Qinyuan72/FYP/Writings_and_Reports/LM118_AY24_25_Project_Interim_Prentation.pdf

10/28/2024

1

# General Purpose Data Acquisition System Using STM32

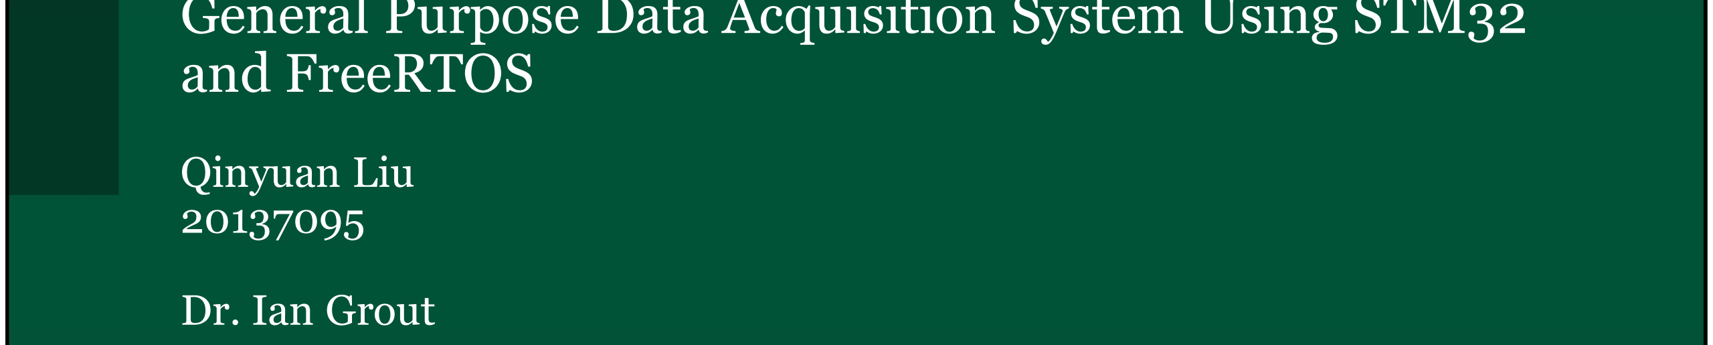
[picture p41: figure]
and FreeRTOS; Qinyuan Liu 20137095; Dr. Ian Grout

### LM118: BEng in Electronic and Computer Engineering Autumn semester 2024 Interim Presentation

# Presentation Overview

- Project introduction and objectives
- Hardware System design.
- Software System design
- Gantt chart
- Conclusions and next steps

1

2

# Project Overview – Hardware

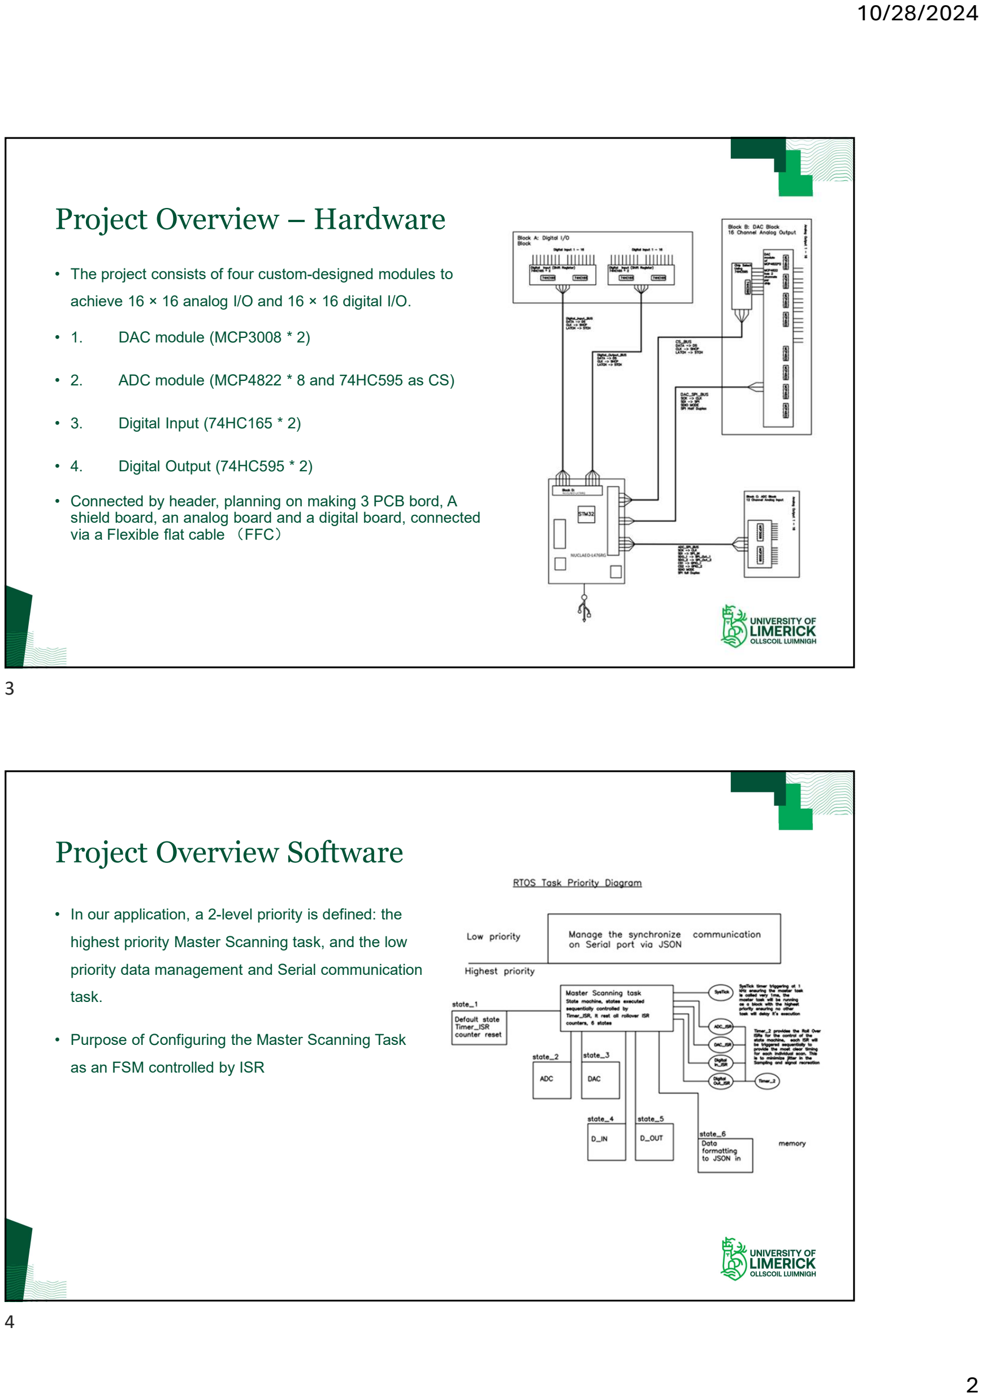
[picture p42: page 2]

2

- The project consists of four custom-designed modules to achieve 16 × 16 analog I/O and 16 × 16 digital I/O.
- 1. | DAC module (MCP3008 * 2)
- 2. | ADC module (MCP4822 * 8 and 74HC595 as CS)
- 3. | Digital Input (74HC165 * 2)
- 4. | Digital Output (74HC595 * 2)
- Connected by header, planning on making 3 PCB bord, A shield board, an analog board and a digital board, connected via a Flexible flat cable （FFC）

# Project Overview Software

- In our application, a 2-level priority is defined: the highest priority Master Scanning task, and the low priority data management and Serial communication task.
- Purpose of Configuring the Master Scanning Task as an FSM controlled by ISR

3

4

3

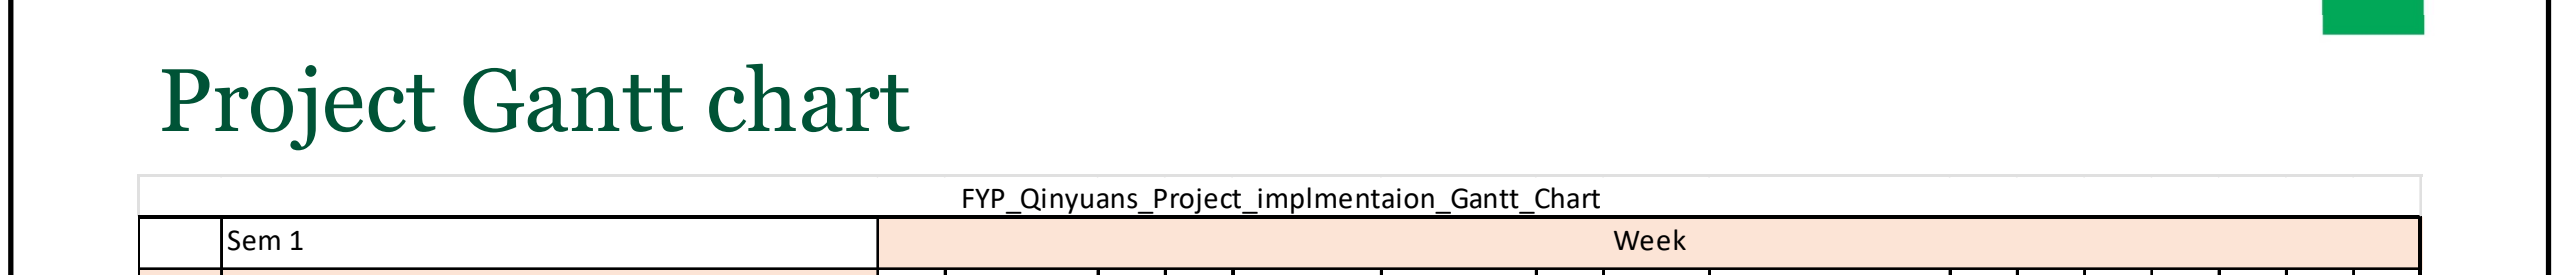
[picture p43: figure]
Project Gantt chart Sem 1

Task no. | Ground work (Background research and learning ) Task | 0 0 | 0 1 | 0 2 | 0 3 | 0 4 | 5 | 6 | 7 | 8 | 9 | 10 | 11 | 12 | 13 | 14 - 1 | END
2 | Interim Report | - | - | - | - | 0 | 0 | 0 | Dead Line Behind | Behind schedule!!!- | | - | - | - | Exam | Exam | END
3 | Schematic Design | - | - | - | - | 0 | 0 | 0 | 0 | DONE | - | - | - | - | Exam | Exam | END
4 | Autumn Semester Presentation | - | - | - | - | 0 | 0 | 0 | 0 | Due to injry, I can's persent prot ot ype (delayed), but it's well | - | - | - | - | Exam | Exam | END
5 | Code Development | - | - | - | - | - | - | - | - | 0 | 0 | 0 | 0 | 0 | Exam | Exam | END
6 | PCB Layout Task | ---1 -2 -3 -4 -5 -END ----0 0 Exam Exam END Winter Break Task no.
1 | First PCB Schematic and Layout | - | Christmas | 0 | 0 Order PCB | | | END
2 | PCB Testing | - | | - | - | - | 0 END
| Sem 2
Task no. | Final Report Due & Presentation Task | -- | 1 0 | 2 0 | 3 0 | 4 0 | 5 0 | 6 0 Final Report Due & | 7 | 8 | END 9 | - | - | - | - | - | - 1
2 | PCB with STM32 on borad | - | 0 Ord | | - | - | - | - | - | | END
3 | PCB Testing | - | - | - | 0 | 0 | Syst em Verif icat ion | - | - | | END

## Week Week Week

FYP_Qinyuans_Project_implmentaion_Gantt_Chart

# Conclusions

- Project summary:
- Prototype schematics done, the nest step will of implementing the prototype will exciting yet challenging, I am expecting imperfection and improvement in the current schematics, as well as challenges in implementing the relatively complexed RTOS code architecture, after prototype, we will be focused on dishing the custom PCB.
- Work completed to-date:
- Significant progress has been made in understanding and developing the foundations of the project, a schematic has been made while the breadboard testing prototype is under development.
- Next steps:
- Hard ware: Finish the porotype on a bread board.
- Soft ware: Finish the prototype some ware that will be the foundation in next step.

5

6

4

Thank you.

# Any questions?

7
