Qinyuan72/FYP/STM32CubeIDEworkspace_1.13.0/MCP3008/MCP3008.pdf

14/11/2024

MCP3008 Project
Configuration Report

## 1. Description

### 1.1. Project

Project Name | MCP3008
Board Name | NUCLEO-L476RG
Generated with: | STM32CubeMX 6.11.0
Date | 11/14/2024

### 1.2. MCU

MCU Series | STM32L4
MCU Line | STM32L4x6
MCU name | STM32L476RGTx
MCU Package | LQFP64
MCU Pin number | 64

### 1.3. Core(s) information

Core(s) | Arm Cortex-M4

## 2. Pinout Configuration

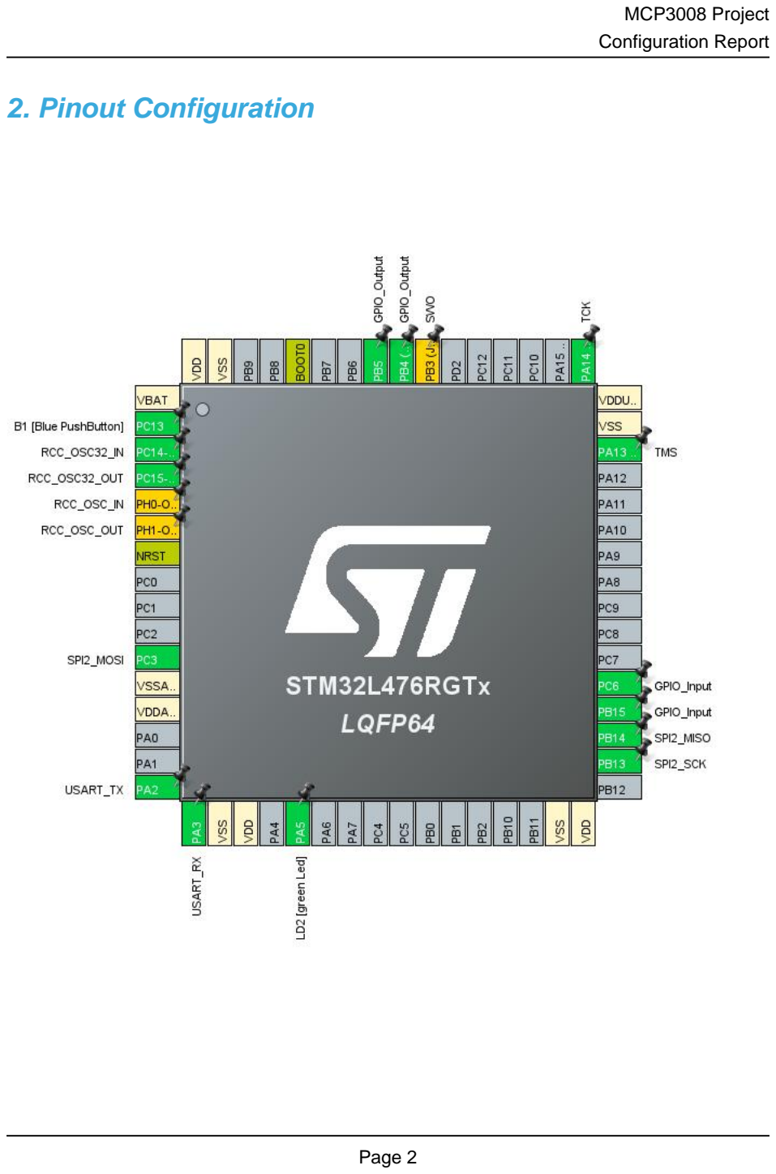
[picture p50: page 3]

## 3. Pins Configuration

Pin Number LQFP64 | Pin Name (function after reset) | Pin Type | Alternate Function(s) | Label
1 | VBAT | Power
2 | PC13 | I/O | GPIO_EXTI13 | B1 [Blue PushButton]
3 | PC14-OSC32_IN (PC14) | I/O | RCC_OSC32_IN
4 | PC15-OSC32_OUT (PC15) | I/O | RCC_OSC32_OUT
5 | PH0-OSC_IN (PH0) * | I/O | RCC_OSC_IN
6 | PH1-OSC_OUT (PH1) * | I/O | RCC_OSC_OUT
7 | NRST | Reset
11 | PC3 | I/O | SPI2_MOSI
12 | VSSA/VREF- | Power
13 | VDDA/VREF+ | Power
16 | PA2 | I/O | USART2_TX | USART_TX
17 | PA3 | I/O | USART2_RX | USART_RX
18 | VSS | Power
19 | VDD | Power
21 | PA5 ** | I/O | GPIO_Output | LD2 [green Led]
31 | VSS | Power
32 | VDD | Power
34 | PB13 | I/O | SPI2_SCK
35 | PB14 | I/O | SPI2_MISO
36 | PB15 ** | I/O | GPIO_Input
37 | PC6 ** | I/O | GPIO_Input
46 | PA13 (JTMS-SWDIO) | I/O | SYS_JTMS-SWDIO | TMS
47 | VSS | Power
48 | VDDUSB | Power
49 | PA14 (JTCK-SWCLK) | I/O | SYS_JTCK-SWCLK | TCK
55 | PB3 (JTDO-TRACESWO) * | I/O | SYS_JTDO-SWO | SWO
56 | PB4 (NJTRST) ** | I/O | GPIO_Output
57 | PB5 ** | I/O | GPIO_Output
60 | BOOT0 | Boot
63 | VSS | Power
64 | VDD | Power

** The pin is affected with an I/O function
* The pin is affected with a peripheral function but no peripheral mode is activated

## 4. Clock Tree Configuration

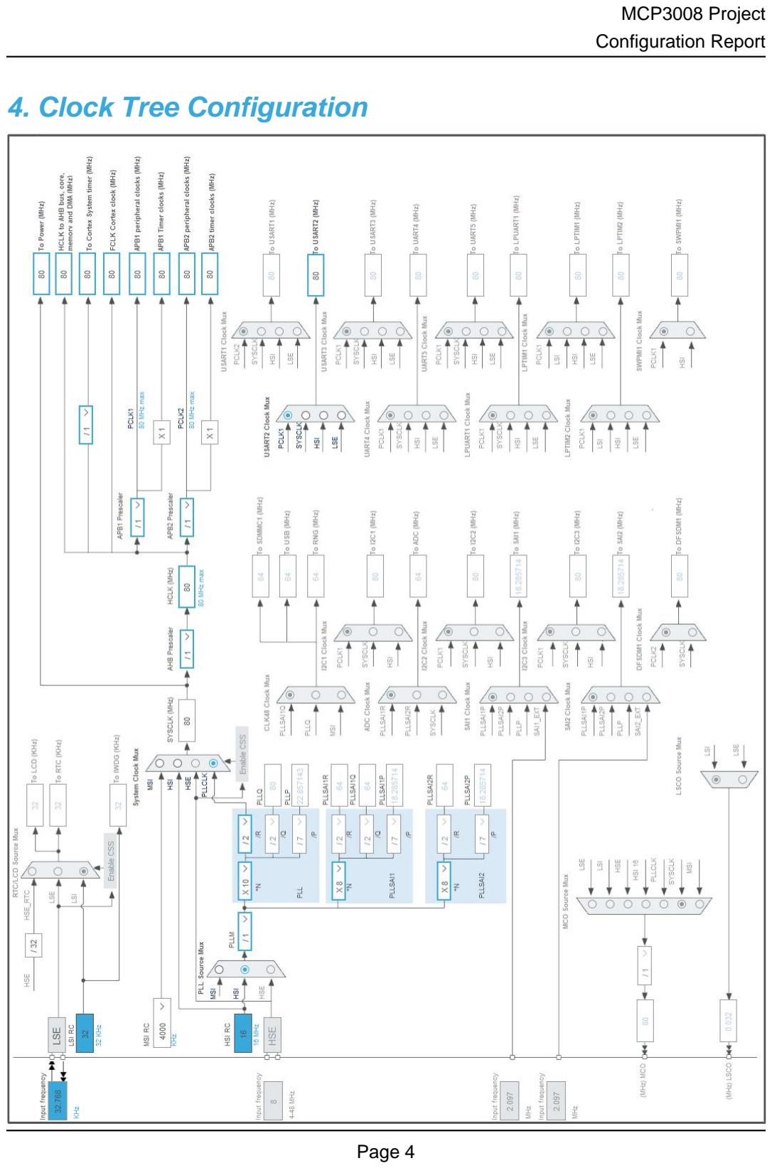
[picture p51: page 5]

## 5. Software Project

### 5.1. Project Settings

Name | Value
Project Name | MCP3008
Project Folder | D:\Develop\FYP\STM32CubeIDEworkspace_1.13.0\MCP3008
Toolchain / IDE | STM32CubeIDE
Firmware Package Name and Version | STM32Cube FW_L4 V1.18.1
Application Structure | Advanced
Generate Under Root | Yes
Do not generate the main() | No
Minimum Heap Size | 0x200
Minimum Stack Size | 0x400

### 5.2. Code Generation Settings

Name | Value
STM32Cube MCU packages and embedded software | Copy only the necessary library files
Generate peripheral initialization as a pair of '.c/.h' files | No
Backup previously generated files when re-generating | No
Keep User Code when re-generating | Yes
Delete previously generated files when not re-generated | Yes
Set all free pins as analog (to optimize the power consumption) | No
Enable Full Assert | No

### 5.3. Advanced Settings - Generated Function Calls

Rank | Function Name | Peripheral Instance Name
1 | SystemClock_Config | RCC
2 | MX_GPIO_Init | GPIO
3 | MX_USART2_UART_Init | USART2
4 | MX_SPI2_Init | SPI2

## 1. Power Consumption Calculator report

### 1.1. Microcontroller Selection

Series | STM32L4
Line | STM32L4x6
MCU | STM32L476RGTx
Datasheet | DS10198_Rev4

### 1.2. Parameter Selection

Temperature | 25
Vdd | 3.0

### 1.3. Battery Selection

Battery | Li-SOCL2(A3400)
Capacity | 3400.0 mAh
Self Discharge | 0.08 %/month
Nominal Voltage | 3.6 V
Max Cont Current | 100.0 mA
Max Pulse Current | 200.0 mA
Cells in series | 1
Cells in parallel | 1

### 1.4. Sequence

Step | Step1 | Step2
Mode | RUN | STOP2
Vdd | 3.0 | 3.0
Voltage Source | Battery | Battery
Range | Range1-High | NoRange
Fetch Type | SRAM2 | n/a
CPU Frequency | 80 MHz | 0 Hz
Clock Configuration | HSE PLL | ALL CLOCKS OFF
Clock Source Frequency | 4 MHz | 0 Hz
Peripherals
Additional Cons. | 0 mA | 0 mA
Average Current | 10.7 mA | 1.18 µA
Duration | 0.1 ms | 0.9 ms
DMIPS | 100.0 | 0.0
Ta Max | 103.56 | 105
Category | In DS Table | In DS Table

### 1.5. Results

Sequence Time | 1 ms | Average Current | 1.07 mA
Battery Life | 4 months, 10 days, 3 hours | Average DMIPS | 100.0 DMIPS

### 1.6. Chart

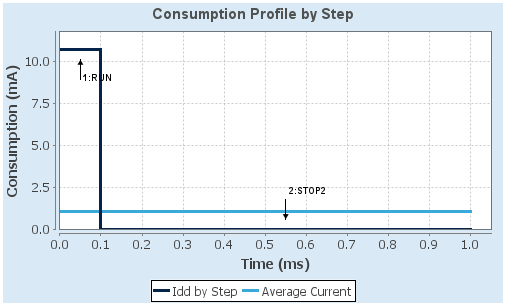
[picture p52: figure]

## 2. Peripherals and Middlewares Configuration

### 2.1. RCC

Low Speed Clock (LSE) : Crystal/Ceramic Resonator
2.1.1. Parameter Settings:

System Parameters:

VDD voltage (V) | 3.3
Instruction Cache | Enabled
Prefetch Buffer | Enabled *
Data Cache | Enabled
Flash Latency(WS) | 4 WS (5 CPU cycle)
RCC Parameters:
HSI Calibration Value | 16
MSI Calibration Value | 0
MSI Auto Calibration | Disabled
HSE Startup Timout Value (ms) | 100
LSE Startup Timout Value (ms) | 5000
Power Parameters:
Power Regulator Voltage Scale | Power Regulator Voltage Scale 1

### 2.2. SPI2

Mode: Full-Duplex Master
2.2.1. Parameter Settings:

Basic Parameters:

Frame Format | Motorola
Data Size | 4 Bits
First Bit | MSB First
Clock Parameters:
Prescaler (for Baud Rate) | 2
Baud Rate | 40.0 MBits/s *
Clock Polarity (CPOL) | Low
Clock Phase (CPHA) | 1 Edge
Advanced Parameters:
CRC Calculation | Disabled
NSSP Mode | Enabled
NSS Signal Type | Software

### 2.3. SYS

Debug: Serial Wire
Timebase Source: SysTick

### 2.4. USART2

Mode: Asynchronous
2.4.1. Parameter Settings:

Basic Parameters:

Baud Rate | 115200
Word Length | 8 Bits (including Parity)
Parity | None
Stop Bits | 1
Advanced Parameters:
Data Direction | Receive and Transmit
Over Sampling | 16 Samples
Single Sample | Disable
Advanced Features:
Auto Baudrate | Disable
TX Pin Active Level Inversion | Disable
RX Pin Active Level Inversion | Disable
Data Inversion | Disable
TX and RX Pins Swapping | Disable
Overrun | Enable
DMA on RX Error | Enable
MSB First | Disable

* User modified value

## 3. System Configuration

### 3.1. GPIO configuration

IP | Pin | Signal | GPIO mode | GPIO pull/up pull down | Max Speed | User Label
RCC | PC14-OSC32_IN (PC14) | RCC_OSC32_IN | n/a | n/a | n/a
| PC15-OSC32_OU T (PC15) | RCC_OSC32_O UT | n/a | n/a | n/a
SPI2 | PC3 | SPI2_MOSI | Alternate Function Push Pull | No pull-up and no pull-down | Very High *
| PB13 | SPI2_SCK | Alternate Function Push Pull | No pull-up and no pull-down | Very High *
| PB14 | SPI2_MISO | Alternate Function Push Pull | No pull-up and no pull-down | Very High *
SYS | PA13 (JTMS-SWDIO) | SYS_JTMS-SWDIO | n/a | n/a | n/a | TMS
| PA14 (JTCK-SWCLK) | SYS_JTCK-SWCLK | n/a | n/a | n/a | TCK
USART2 | PA2 | USART2_TX | Alternate Function Push Pull | No pull-up and no pull-down | Very High * | USART_TX
| PA3 | USART2_RX | Alternate Function Push Pull | No pull-up and no pull-down | Very High * | USART_RX
Single Mapped Signals | PH0-OSC_IN (PH0) | RCC_OSC_IN | n/a | n/a | n/a
| PH1-OSC_OUT (PH1) | RCC_OSC_OUT | n/a | n/a | n/a
| PB3 (JTDO-TRACESWO ) | SYS_JTDO-SWO | n/a | n/a | n/a | SWO
GPIO | PC13 | GPIO_EXTI13 | External Interrupt Mode with Falling edge trigger detection | No pull-up and no pull-down | n/a | B1 [Blue PushButton]
| PA5 | GPIO_Output | Output Push Pull | No pull-up and no pull-down | Low | LD2 [green Led]
| PB15 | GPIO_Input | Input mode | No pull-up and no pull-down | n/a
| PC6 | GPIO_Input | Input mode | No pull-up and no pull-down | n/a
| PB4 (NJTRST) | GPIO_Output | Output Push Pull | No pull-up and no pull-down | Low

IP | Pin | Signal | GPIO mode | GPIO pull/up pull down | Max Speed | User Label
| PB5 | GPIO_Output | Output Push Pull | No pull-up and no pull-down | Low

### 3.2. DMA configuration

nothing configured in DMA service

### 3.3. NVIC configuration

3.3.1. NVIC
Interrupt Table | Enable | Preenmption Priority | SubPriority
Non maskable interrupt | true | 0 | 0
Hard fault interrupt | true | 0 | 0
Memory management fault | true | 0 | 0
Prefetch fault, memory access fault | true | 0 | 0
Undefined instruction or illegal state | true | 0 | 0
System service call via SWI instruction | true | 0 | 0
Debug monitor | true | 0 | 0
Pendable request for system service | true | 0 | 0
System tick timer | true | 0 | 0
PVD/PVM1/PVM2/PVM3/PVM4 interrupts through EXTI lines 16/35/36/37/38 | unused
Flash global interrupt | unused
RCC global interrupt | unused
SPI2 global interrupt | unused
USART2 global interrupt | unused
EXTI line[15:10] interrupts | unused
FPU global interrupt | unused
3.3.2. NVIC Code generation
Enabled interrupt Table | Select for init sequence ordering | Generate IRQ handler | Call HAL handler
Non maskable interrupt | false | true | false
Hard fault interrupt | false | true | false
Memory management fault | false | true | false
Prefetch fault, memory access fault | false | true | false
Undefined instruction or illegal state | false | true | false
System service call via SWI instruction | false | true | false
Debug monitor | false | true | false
Pendable request for system service | false | true | false
System tick timer | false | true | true

* User modified value

## 4. System Views

4.1. Category view
4.1.1. Current

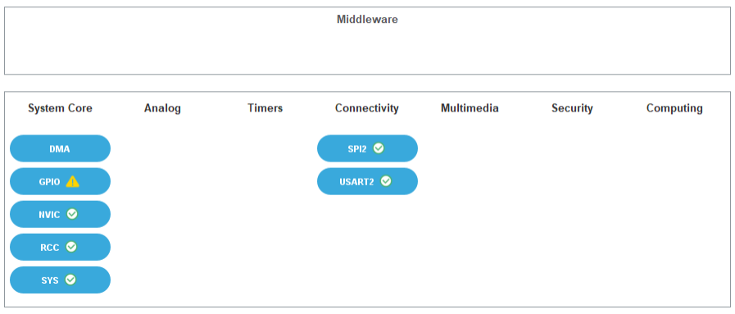
[picture p53: figure]

## 5. Docs & Resources

Type | Link
BSDL files | https://www.st.com/resource/en/bsdl_model/stm32l4_bsdl.zip
IBIS models | https://www.st.com/resource/en/ibis_model/stm32l4_ibis.zip
System View Description | https://www.st.com/resource/en/svd/stm32l4_svd.zip
Presentations | https://www.st.com/resource/en/product_presentation/stm32-stm8_embedded_software_solutions.pdf
Presentations | https://www.st.com/resource/en/product_presentation/stm32_eval-tools_portfolio.pdf
Presentations | https://www.st.com/resource/en/product_presentation/stm32_stm8_functi onal-safety-packages.pdf
Presentations | https://www.st.com/resource/en/product_presentation/stm32-stm8_software_development_tools.pdf
Presentations | https://www.st.com/resource/en/product_presentation/microcontrollers-stm32-family-overview.pdf
Presentations | https://www.st.com/resource/en/product_presentation/microcontrollers-stm32l4-series-product-overview.pdf
Brochures | https://www.st.com/resource/en/brochure/brstm32ulp.pdf
Flyers | https://www.st.com/resource/en/flyer/flstm32l4.pdf
Flyers | https://www.st.com/resource/en/flyer/flstm32nucleo.pdf
Flyers | https://www.st.com/resource/en/flyer/flstmcsuite.pdf
Flyers | https://www.st.com/resource/en/flyer/flstm32trust.pdf
Flyers | https://www.st.com/resource/en/flyer/flstm32gui.pdf
Magazine Articles | https://www.st.com/resource/en/magazine/design-elektronik_august2017.pdf
Magazine Articles | https://www.st.com/resource/en/magazine/design-elektronik_october2016.pdf
Product Certifications | https://www.st.com/resource/en/certification_document/sesip-2000002-01-cert.pdf

Product Certifications | https://www.st.com/resource/en/certification_document/sesip-2000002-01-st2.pdf
Product Certifications | https://www.st.com/resource/en/certification_document/psa-certificate_stm32l4.pdf
Application Notes | https://www.st.com/resource/en/application_note/an1709-emc-design-guide-for-stm8-stm32-and-legacy-mcus-stmicroelectronics.pdf
Application Notes | https://www.st.com/resource/en/application_note/an2606-stm32-microcontroller-system-memory-boot-mode-stmicroelectronics.pdf
Application Notes | https://www.st.com/resource/en/application_note/an2639-soldering-recommendations-and-package-information-for-leadfree-ecopack-mcus-and-mpus-stmicroelectronics.pdf
Application Notes | https://www.st.com/resource/en/application_note/an3126-audio-and-waveform-generation-using-the-dac-in-stm32-products-stmicroelectronics.pdf
Application Notes | https://www.st.com/resource/en/application_note/an3154-can-protocol-used-in-the-stm32-bootloader-stmicroelectronics.pdf
Application Notes | https://www.st.com/resource/en/application_note/an3155-usart-protocol-used-in-the-stm32-bootloader-stmicroelectronics.pdf
Application Notes | https://www.st.com/resource/en/application_note/an3156-usb-dfu-protocol-used-in-the-stm32-bootloader-stmicroelectronics.pdf
Application Notes | https://www.st.com/resource/en/application_note/an4221-i2c-protocol-used-in-the-stm32-bootloader-stmicroelectronics.pdf
Application Notes | https://www.st.com/resource/en/application_note/an4286-spi-protocol-used-in-the-stm32-bootloader-stmicroelectronics.pdf
Application Notes | https://www.st.com/resource/en/application_note/an4555-getting-started-with-stm32l4-series-and-stm32l4-series-hardware-development-stmicroelectronics.pdf
Application Notes | https://www.st.com/resource/en/application_note/an4566-extending-the-dac-performance-of-stm32-microcontrollers-stmicroelectronics.pdf
Application Notes | https://www.st.com/resource/en/application_note/an4612-migrating-from-stm32l1-series-to-stm32l4-series-and-stm32l4-series-microcontrollers-stmicroelectronics.pdf
Application Notes | https://www.st.com/resource/en/application_note/an4616-migrating-from-

| stm32f401-and-stm32f411-lines-to-stm32l4-series-and-stm32l4-series-microcontrollers-stmicroelectronics.pdf
Application Notes | https://www.st.com/resource/en/application_note/an4621-stm32l4-and-stm32l4-ultralowpower-features-overview-stmicroelectronics.pdf
Application Notes | https://www.st.com/resource/en/application_note/an4629-adc-hardware-oversampling-for-microcontrollers-of-the-stm32-l0-and-l4-series-stmicroelectronics.pdf
Application Notes | https://www.st.com/resource/en/application_note/an4649-migrating-from-stm32f1-series-to-stm32l4-series--stm32l4-series-microntrollers-stmicroelectronics.pdf
Application Notes | https://www.st.com/resource/en/application_note/an4655-virtually-increasing-the-number-of-serial-communication-peripherals-in-stm32-applications-stmicroelectronics.p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
Application Notes | https://www.st.com/resource/en/application_note/an4726-stm32cube-firmware-examples-for-stm32l4-series-and-stm32l4-series-stmicroelectronics.pdf
Application Notes | https://www.st.com/resource/en/application_note/an4729-stm32l0l4-firewall-overview-stmicroelectronics.pdf
Application Notes | https://www.st.com/resource/en/application_note/an4730-using-the-firewall-embedded-in-stm32l0l4l4-series-mcus-for-secure-access-to-sensitive-parts-of-code-and-data-s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
Application Notes | https://www.st.com/resource/en/application_note/an4746-optimizing-power-and-performance-with-stm32l4-and-stm32l4-series-microcontrollers-stmicroelectronics.pdf
Application Notes | https://www.st.com/resource/en/application_note/an4750-handling-of-soft-errors-in-stm32-applications-stmicroelectronics.pdf
Application Notes | https://www.st.com/resource/en/application_note/an4754-migrating-between-stm32l486xx476xx-and-stm32l443xx433xx-microcontrollers-stmicroelectronics.pdf
Application Notes | https://www.st.com/resource/en/application_note/an4776-generalpurpose-timer-cookbook-for-stm32-microcontrollers-stmicroelectronics.pdf
Application Notes | https://www.st.com/resource/en/application_note/an4803-highspeed-si-simulations-using-ibis-and-boardlevel-simulations-using-hyperlynx-si-on-stm32-mcus-and-mpus-stmic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

Application Notes | https://www.st.com/resource/en/application_note/an4809-migrating-between-stm32l0-series-and-stm32l4-series--stm32l4-series-microcontrollers-stmicroelectronics.pdf
Application Notes | https://www.st.com/resource/en/application_note/an4821-migrating-from-stm32f405415-line-and-stm32f407417-line-to-stm32l4-series-and-stm32l4-series-microcontrollers-s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
Application Notes | https://www.st.com/resource/en/application_note/an4822-migrating-between-stm32l476xx486xx-and-stm32l496xx4a6xx-microcontrollers-stmicroelectronics.pdf
Application Notes | https://www.st.com/resource/en/application_note/an4831-migrating-from-stm32f2x5-line-to-stm32l4-series-and-stm32l4-series-microcontrollers-stmicroelectronics.pdf
Application Notes | https://www.st.com/resource/en/application_note/an4832-migrating-from-stm32f303-line-to-stm32l4-series-and-stm32l4-series-microcontrollers-stmicroelectronics.pdf
Application Notes | https://www.st.com/resource/en/application_note/an4989-stm32-microcontroller-debug-toolbox-stmicroelectronics.pdf
Application Notes | https://www.st.com/resource/en/application_note/an4990-getting-started-with-sigmadelta-digital-interface-on-applicable-stm32-microcontrollers-stmicroelectronics.pdf
Application Notes | https://www.st.com/resource/en/application_note/an4995-using-an-electromyogram-technique-to-detect-muscle-activity-stmicroelectronics.pdf
Application Notes | https://www.st.com/resource/en/application_note/an5012-analogtodigital-audio-conversion-example-using-stm32l4-series-microcontroller-peripherals-stmicroelectronics.p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
Application Notes | https://www.st.com/resource/en/application_note/an5017-migrating-between-stm32l476xx486xx-and-stm32l4-series-microcontrollers-stmicroelectronics.pdf
Application Notes | https://www.st.com/resource/en/application_note/an5020-digital-camera-interface-dcmi-on-stm32-mcus-stmicroelectronics.pdf
Application Notes | https://www.st.com/resource/en/application_note/an5027-interfacing-pdm-digital-microphones-using-stm32-mcus-and-mpus-stmicroelectronics.pdf
Application Notes | https://www.st.com/resource/en/application_note/an5105-getting-started-

| with-touch-sensing-control-on-stm32-microcontrollers-stmicroelectronics.pdf
Application Notes | https://www.st.com/resource/en/application_note/an5138-migrating-from-stm32l4-and-stm32l4-to-stm32l5-series-microcontrollers-stmicroelectronics.pdf
Application Notes | https://www.st.com/resource/en/application_note/an5408-migrating-from-stm32l0-stm32l1-and-stm32l4-series-associated-with-sx12xx-transceivers-to-stm32wl-series-microc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
Application Notes | https://www.st.com/resource/en/application_note/an4760-quadspi-interface-on-stm32-microcontrollers-and-microprocessors--stmicroelectronics.pdf
Application Notes | https://www.st.com/resource/en/application_note/an4899-stm32-microcontroller-gpio-hardware-settings-and-lowpower-consumption-stmicroelectronics.pdf
Application Notes | https://www.st.com/resource/en/application_note/an5612-esd-protection-of-stm32-mcus-and-mpus-stmicroelectronics.pdf
Application Notes | https://www.st.com/resource/en/application_note/an4991-how-to-wake-up-an-stm32-microcontroller-from-lowpower-mode-with-the-usart-or-the-lpuart-stmicroelectronics.pdf
Application Notes | https://www.st.com/resource/en/application_note/an4838-introduction-to-memory-protection-unit-management-on-stm32-mcus-stmicroelectronics.pdf
Application Notes | https://www.st.com/resource/en/application_note/an4879-introduction-to-usb-hardware-and-pcb-guidelines-using-stm32-mcus-stmicroelectronics.pdf
Application Notes | https://www.st.com/resource/en/application_note/an5372-migrating-from-stm32l4-and-stm32l4--to-stm32u5-mcus-stmicroelectronics.pdf
Application Notes | https://www.st.com/resource/en/application_note/an5225-introduction-to-usb-typec-power-delivery-for-stm32-mcus-and-mpus-stmicroelectronics.pdf
Application Notes | https://www.st.com/resource/en/application_note/an4777-how-to-optimize-power-consumption-on-stm32-mcus-stmicroelectronics.pdf
Application Notes | https://www.st.com/resource/en/application_note/an4894-how-to-use-eeprom-emulation-on-stm32-mcus-stmicroelectronics.pdf

Application Notes | https://www.st.com/resource/en/application_note/an2834-how-to-optimize-the-adc-accuracy-in-the-stm32-mcus-stmicroelectronics.pdf
Application Notes | https://www.st.com/resource/en/application_note/an5537-how-to-use-adc-oversampling-techniques-to-improve-signaltonoise-ratio-on-stm32-mcus-stmicroelectronics.pdf
Application Notes | https://www.st.com/resource/en/application_note/an5036-guidelines-for-thermal-management-on-stm32-applications-stmicroelectronics.pdf
Application Notes | https://www.st.com/resource/en/application_note/an5690-how-to-use-vrefbuf-peripheral-on-stm32-mcus-and-mpus-stmicroelectronics.pdf
Application Notes | https://www.st.com/resource/en/application_note/an4230-introduction-to-random-number-generation-validation-using-the-nist-statistical-test-suite-for-stm32-mcus-and-m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
Application Notes | https://www.st.com/resource/en/application_note/an2548-introduction-to-dma-controller-for-stm32-mcus-stmicroelectronics.pdf
Application Notes | https://www.st.com/resource/en/application_note/an2867-guidelines-for-oscillator-design-on-stm8afals-and-stm32-mcusmpus-stmicroelectronics.pdf
Application Notes | https://www.st.com/resource/en/application_note/an3236-how-to-increase-the-number-of-touchkeys-for-touch-sensing-applications-on-stm32-mcus-stmicroelectronics.pdf
Application Notes | https://www.st.com/resource/en/application_note/an3960-guidelines-for-esd-for-touch-sensing-applications-on-stm32-mcus-stmicroelectronics.pdf
Application Notes | https://www.st.com/resource/en/application_note/an4013-introduction-to-timers-for-stm32-mcus-stmicroelectronics.pdf
Application Notes | https://www.st.com/resource/en/application_note/an4277-how-to-use-pwm-shutdown-for-motor-control-and-digital-power-conversion-on-stm32-mcus-stmicroelectronics.pdf
Application Notes | https://www.st.com/resource/en/application_note/an4299-how-to-improve-conducted-noise-robustness-for-touch-sensing-applications-on-stm32-mcus-stmicroelectronics.pdf
Application Notes | https://www.st.com/resource/en/application_note/an4310-how-to-choose-the-sampling-capacitor-for-touch-sensing-applications-on-stm32-mcus-stmicroelectronics.pdf

Application Notes | https://www.st.com/resource/en/application_note/an4312-how-to-design-surface-sensors-for-touch-sensing-applications-on-stm32-mcus-stmicroelectronics.pdf
Application Notes | https://www.st.com/resource/en/application_note/an4316-how-to-tune-touch-sensing-applications-on-stm32-mcus-stmicroelectronics.pdf
Application Notes | https://www.st.com/resource/en/application_note/an4635-how-to-optimize-lpuart-power-consumption-on-stm32-mcus-stmicroelectronics.pdf
Application Notes | https://www.st.com/resource/en/application_note/an4759-introduction-to-using-the-hardware-realtime-clock-rtc-and-the-tamper-management-unit-tamp-with-stm32-mcus-stmi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
Application Notes | https://www.st.com/resource/en/application_note/an4908-getting-started-with-usart-automatic-baud-rater-detection-for-stm32-mcus-stmicroelectronics.pdf
Application Notes | https://www.st.com/resource/en/application_note/an4943-how-to-use-chromart-accelerator-to-refresh-an-lcdtft-display-on-stm32-mcus-stmicroelectronics.pdf
Application Notes | https://www.st.com/resource/en/application_note/an5156-introduction-to-security-for-stm32-mcus-stmicroelectronics.pdf
Application Notes | https://www.st.com/resource/en/application_note/an5543-guidelines-for-enhanced-spi-communication-on-stm32-mcus-and-mpus-stmicroelectronics.pdf
Application Notes for related Tools & Software | https://www.st.com/resource/en/application_note/an1202_freertos_guide-freertos-guide-stmicroelectronics.pdf
Application Notes for related Tools & Software | https://www.st.com/resource/en/application_note/an1602_semihosting_in_truestudio-how-to-do-semihosting-in-truestudio-stmicroelectronics.pdf
Application Notes for related Tools & Software | https://www.st.com/resource/en/application_note/an1801_stm32cubeprogrammer_in_truestudio-installing-stm32cubeprogrammer-in-truestudio-stmicroelectronics.pdf
Application Notes for related Tools & Software | https://www.st.com/resource/en/application_note/atollic_editing_keyboard_shortcuts-atollic-editing-keyboard-shortcuts-stmicroelectronics.pdf

Application Notes for related Tools & Software | https://www.st.com/resource/en/application_note/iar_to_atollic_truestudio_migration_guide-truestudio-for-arm-migration-guide-iar-embedded-workbench-to-truestudio-stm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
Application Notes for related Tools & Software | https://www.st.com/resource/en/application_note/stm32cubemx_installation_in_truestudio-stm32cubemx-installation-in-truestudio-stmicroelectronics.pdf
Application Notes for related Tools & Software | https://www.st.com/resource/en/application_note/an4044-floating-point-unit-demonstration-on-stm32-microcontrollers-stmicroelectronics.pdf
Application Notes for related Tools & Software | https://www.st.com/resource/en/application_note/an4323-getting-started-with-stemwin-library-stmicroelectronics.pdf
Application Notes for related Tools & Software | https://www.st.com/resource/en/application_note/an4435-guidelines-for-obtaining-ulcsaiec-607301603351-class-b-certification-in-any-stm32-application-stmicroelectroni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
Application Notes for related Tools & Software | https://www.st.com/resource/en/application_note/an4631-how-to-calibrate-an-stm32l0xx-internal-rc-oscillator-stmicroelectronics.pdf
Application Notes for related Tools & Software | https://www.st.com/resource/en/application_note/an4657-stm32-inapplication-programming-iap-using-the-usart-stmicroelectronics.pdf
Application Notes for related Tools & Software | https://www.st.com/resource/en/application_note/an4666-parallel-synchronous-transmission-using-gpio-and-dma-stmicroelectronics.pdf
Application Notes for related Tools & Software | https://www.st.com/resource/en/application_note/an4701-proprietary-code-readout-protection-on-microcontrollers-of-the-stm32f4-series-stmicroelectronics.pdf
Application Notes for related Tools & Software | https://www.st.com/resource/en/application_note/an4726-stm32cube-firmware-examples-for-stm32l4-series-and-stm32l4-series-stmicroelectronics.pdf
Application Notes for related Tools & Software | https://www.st.com/resource/en/application_note/an4736-how-to-calibrate-stm32l4-series-microcontrollers-internal-rc-oscillator-stmicroelectronics.pdf
Application Notes | https://www.st.com/resource/en/application_note/an4758-proprietary-

for related Tools & Software | code-readout-protection-on-stm32l4-stm32l4-stm32g4-and-stm32wb-series-mcus-stmicroelectronics.pdf
Application Notes for related Tools & Software | https://www.st.com/resource/en/application_note/an4767-onthefly-firmware-update-for-dual-bank-stm32-microcontrollers-stmicroelectronics.pdf
Application Notes for related Tools & Software | https://www.st.com/resource/en/application_note/an4834-implementation-of-transmitters-and-receivers-for-infrared-remote-control-protocols-with-stm32cube-stmicroelect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
Application Notes for related Tools & Software | https://www.st.com/resource/en/application_note/an4841-digital-signal-processing-for-stm32-microcontrollers-using-cmsis-stmicroelectronics.pdf
Application Notes for related Tools & Software | https://www.st.com/resource/en/application_note/an4968-proprietary-code-read-out-protection-pcrop-on-stm32f72xxx-and-stm32f73xxx-microcontrollers-stmicroelectronics.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
Application Notes for related Tools & Software | https://www.st.com/resource/en/application_note/an5056-integration-guide-for-the-xcubesbsfu-stm32cube-expansion-package-stmicroelectronics.pdf
Application Notes for related Tools & Software | https://www.st.com/resource/en/application_note/an5282-using-xcuberccalib-software-to-calibrate-stm32wb-series-internal-rc-oscillators-stmicroelectronics.pdf
Application Notes for related Tools & Software | https://www.st.com/resource/en/application_note/an5360-getting-started-with-projects-based-on-the-stm32mp1-series-in-stm32cubeide-stmicroelectronics.pdf
Application Notes for related Tools & Software | https://www.st.com/resource/en/application_note/an5361-getting-started-with-projects-based-on-dualcore-stm32h7-microcontrollers-in-stm32cubeide-stmicroelectronics.pd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
Application Notes for related Tools & Software | https://www.st.com/resource/en/application_note/an5394-getting-started-with-projects-based-on-the-stm32l5-series-in-stm32cubeide-stmicroelectronics.pdf
Application Notes for related Tools & Software | https://www.st.com/resource/en/application_note/an5418-how-to-build-a-simple-usbpd-sink-application-with-stm32cubemx-stmicroelectronics.pdf

Application Notes
for related Tools

https://www.st.com/resource/en/application_note/an5426-migratinggraphics-middleware-projects-from-stm32cubemx-540-to-stm32cubemx-

& Software | 550-stmicroelectronics.pdf
Application Notes for related Tools & Software | https://www.st.com/resource/en/application_note/an5564-getting-started-with-projects-based-on-dualcore-stm32wl-microcontrollers-in-stm32cubeide-stmicroelectronics.pd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
Application Notes for related Tools & Software | https://www.st.com/resource/en/application_note/an4865-lowpower-timer-lptim-applicative-use-cases-on-stm32-mcus-and-mpus-stmicroelectronics.pdf
Application Notes for related Tools & Software | https://www.st.com/resource/en/application_note/an5676-how-to-calibrate-internal-rc-oscillators-on-stm32u5-series-stmicroelectronics.pdf
Application Notes for related Tools & Software | https://www.st.com/resource/en/application_note/an5698-adapting-the-xcubestl-functional-safety-package-for-stm32-iec-61508-compliant-to-other-safety-standards-stmicr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
Application Notes for related Tools & Software | https://www.st.com/resource/en/application_note/an5731-stm32cubemx-and-stm32cubeide-threadsafe-solution-stmicroelectronics.pdf
Application Notes for related Tools & Software | https://www.st.com/resource/en/application_note/an5857-using-xcuberccalib-software-to-calibrate-stm32c0-series-internal-rc-oscillator-stmicroelectronics.pdf
Application Notes for related Tools & Software | https://www.st.com/resource/en/application_note/an4502-stm32-smbuspmbus-expansion-package-for-stm32cube-stmicroelectronics.pdf
Application Notes for related Tools & Software | https://www.st.com/resource/en/application_note/an5126-how-to-calibrate-internal-oscillators-on-stm32g0-mcus-stmicroelectronics.pdf
Application Notes for related Tools & Software | https://www.st.com/resource/en/application_note/an4777-how-to-optimize-power-consumption-on-stm32-mcus-stmicroelectronics.pdf
Application Notes for related Tools & Software | https://www.st.com/resource/en/application_note/an5952-how-to-use-cmake-in-stm32cubeide-stmicroelectronics.pdf
Application Notes for related Tools & Software | https://www.st.com/resource/en/application_note/an4894-how-to-use-eeprom-emulation-on-stm32-mcus-stmicroelectronics.pdf

Application Notes for related Tools & Software | https://www.st.com/resource/en/application_note/an4635-how-to-optimize-lpuart-power-consumption-on-stm32-mcus-stmicroelectronics.pdf
Application Notes for related Tools & Software | https://www.st.com/resource/en/application_note/an5054-how-to-perform-secure-programming-using-stm32cubeprogrammer-stmicroelectronics.pdf
Design Notes & Tips | https://www.st.com/resource/en/design_tip/dt0088-fir-filter-design-by-sampling-windowing-and-modulating-the-sinc-function-stmicroelectronics.pdf
Design Notes & Tips | https://www.st.com/resource/en/design_tip/dt0089-the-goertzel-algorithm-to-compute-individual-terms-of-the-discrete-fourier-transform-dft-stmicroelectronics.pdf
Design Notes & Tips | https://www.st.com/resource/en/design_tip/dt0091-lattice-wave-digital-filter-design-and-automatic-c-code-generation-stmicroelectronics.pdf
Design Notes & Tips | https://www.st.com/resource/en/design_tip/dt0092-lattice-wave-digital-filter-test-and-performance-verification-stmicroelectronics.pdf
Design Notes & Tips | https://www.st.com/resource/en/design_tip/dt0117-microphone-array-beamforming-in-the-pcm-and-pdm-domain-stmicroelectronics.pdf
Errata Sheets | https://www.st.com/resource/en/errata_sheet/es0250-stm32l476xxstm32l486xx-device-errata-stmicroelectronics.pdf
Datasheet | https://www.st.com/resource/en/datasheet/dm00108832.pdf
Programming Manuals | https://www.st.com/resource/en/programming_manual/pm0214-stm32-cortexm4-mcus-and-mpus-programming-manual-stmicroelectronics.pdf
Reference Manuals | https://www.st.com/resource/en/reference_manual/rm0351-stm32l47xxx-stm32l48xxx-stm32l49xxx-and-stm32l4axxx-advanced-armbased-32bit-mcus-stmicroelectronics.pdf
Technical Notes & Articles | https://www.st.com/resource/en/technical_note/tn1163-description-of-wlcsp-for-microcontrollers-and-recommendations-for-its-use-stmicroelectronics.pdf
Technical Notes & Articles | https://www.st.com/resource/en/technical_note/tn1204-tape-and-reel-shipping-media-for-stm32-microcontrollers-in-bga-packages-stmicroelectronics.pdf
Technical Notes | https://www.st.com/resource/en/technical_note/tn1205-tape-and-reel-

& Articles | shipping-media-for-stm8-and-stm32-microcontrollers-in-fpn-packages-stmicroelectronics.pdf
Technical Notes & Articles | https://www.st.com/resource/en/technical_note/tn1206-tape-and-reel-shipping-media-for-stm8-and-stm32-microcontrollers-in-qfp-packages-stmicroelectronics.pdf
Technical Notes & Articles | https://www.st.com/resource/en/technical_note/tn1207-tape-and-reel-shipping-media-for-stm8-and-stm32-microcontrollers-in-so-packages-stmicroelectronics.pdf
Technical Notes & Articles | https://www.st.com/resource/en/technical_note/tn1208-tape-and-reel-shipping-media-for-stm8-and-stm32-microcontrollers-in-tssop-and-ssop-packages-stmicroelectronics.p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
Technical Notes & Articles | https://www.st.com/resource/en/technical_note/tn1433-reference-device-marking-schematics-for-stm32-microcontrollers-and-microprocessors-stmicroelectronics.pdf
Technical Notes & Articles | https://www.st.com/resource/en/technical_note/tn1489-security-bulletin-tn1489stpsirt-physical-attacks-on-stm32-and-stm32cube-firmware-stmicroelectronics.pdf
User Manuals | https://www.st.com/resource/en/user_manual/um2305-stm32l4-and-stm32l4-series-safety-manual-stmicroelectronics.pdf
User Manuals | https://www.st.com/resource/en/user_manual/um3166-stm32l4-and-stm32l4-series-ulcsaiec-607301603351-selftest-library-user-guide-stmicroelectronics.pdf
