Qinyuan72/FYP/(list of files, cad)

Other CAD files:
Drawings/AutoCAD/FYP_Block_DIagram_Print.dwg
Drawings/AutoCAD/RTOS task priority diagram.dwg
