Qinyuan72/FYP/Printables/PNG/FYP_Block_DIagra_Print-1.png

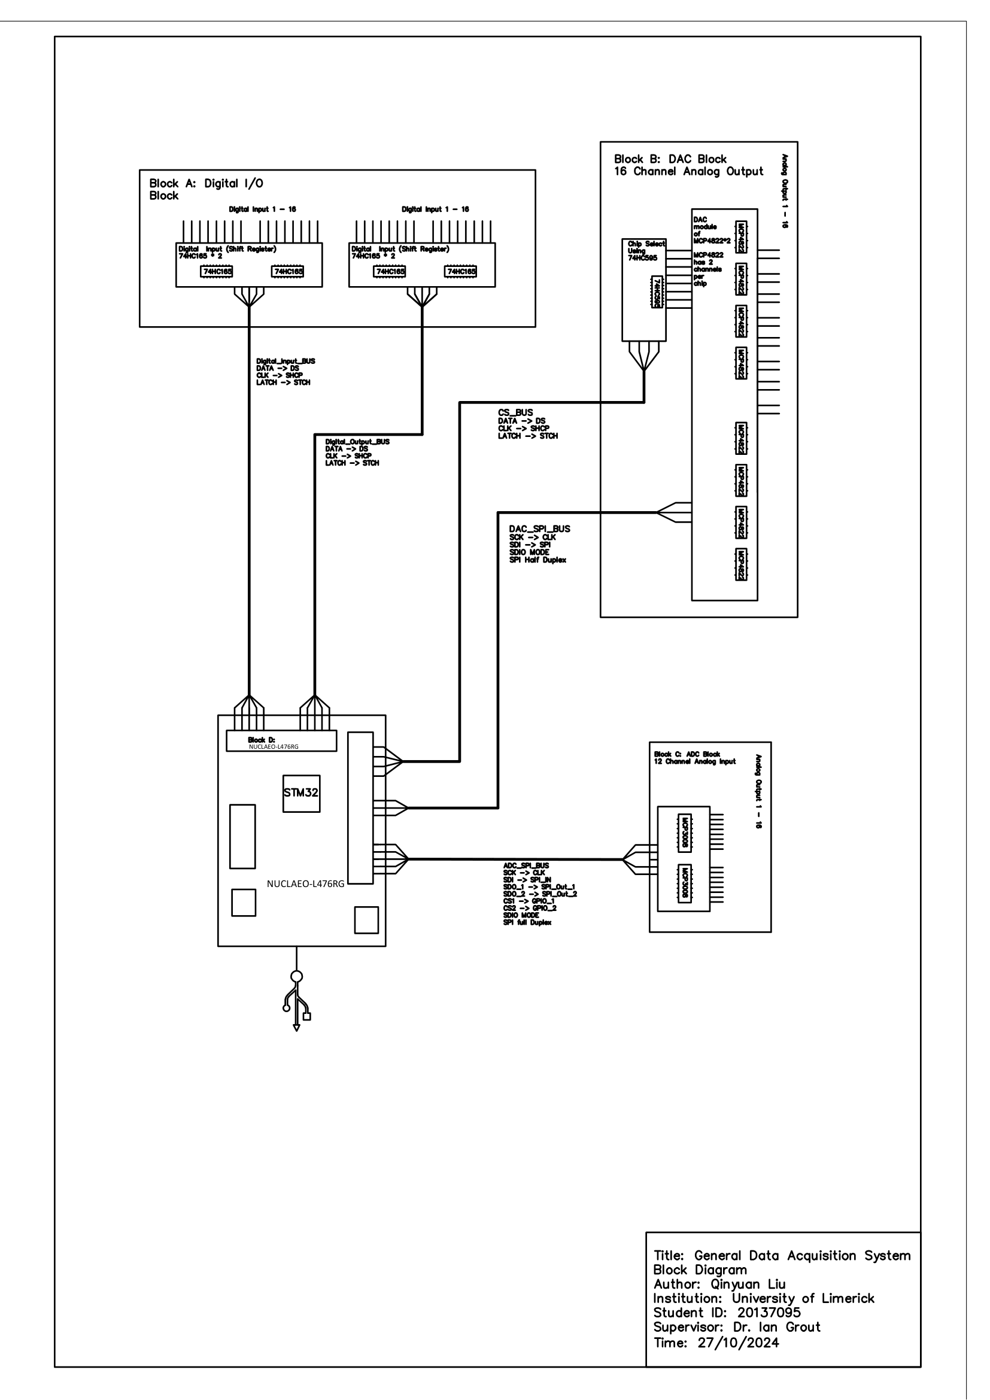
Printables/PNG/FYP_Block_DIagra_Print-1.png
