Qinyuan72/FYP/Printables/PNG/RTOS task priority diagram-1.png

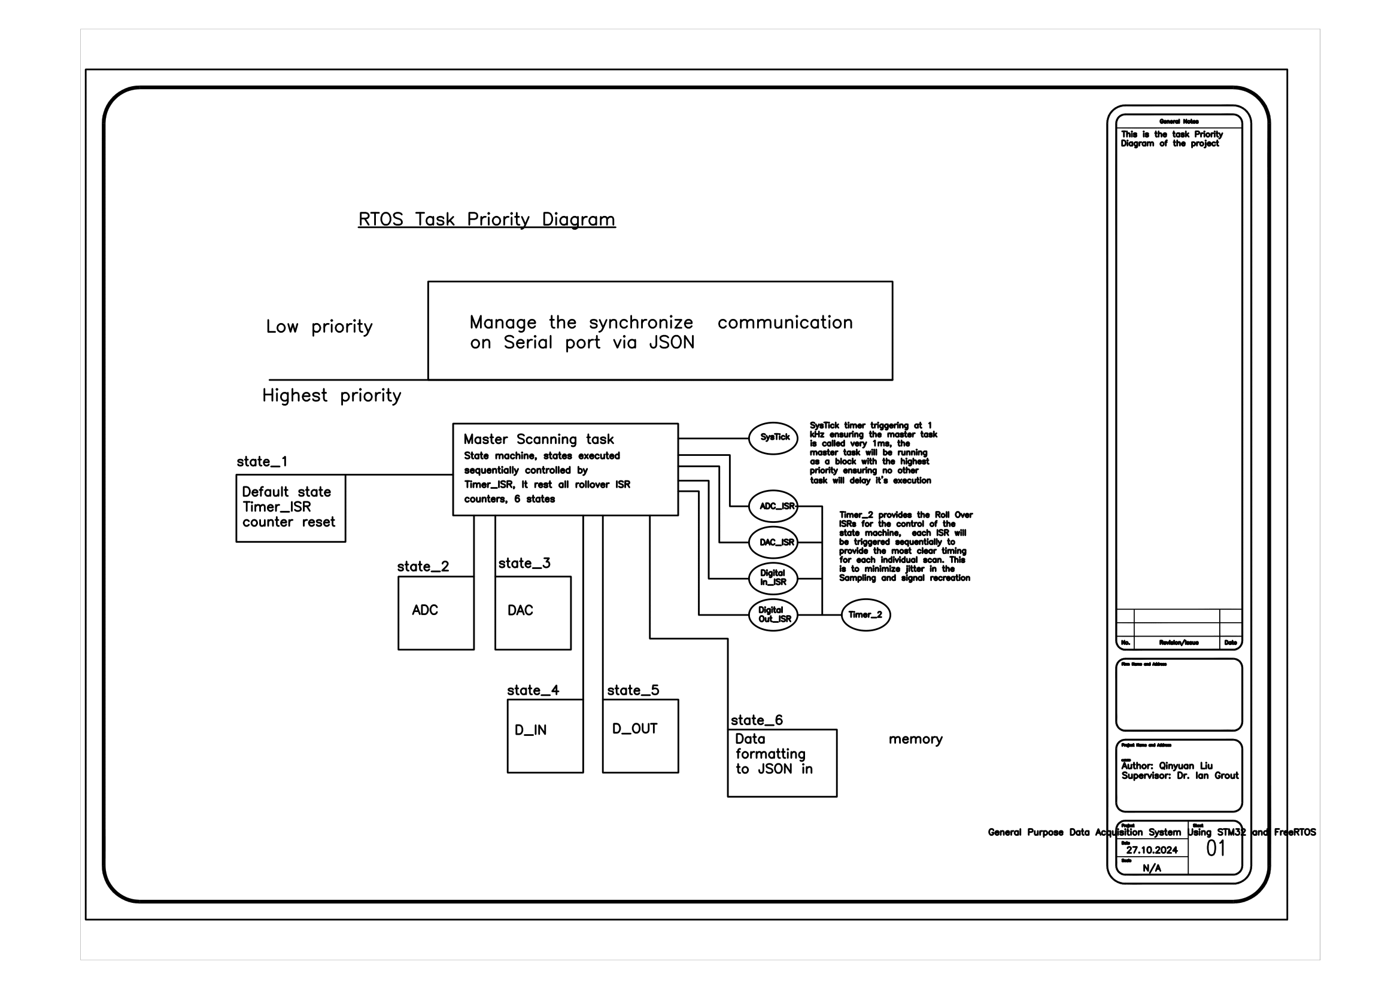
Printables/PNG/RTOS task priority diagram-1.png
