Qinyuan72/FYP/Printables/PNG/STM32_FYP_DAC_Module-1.png

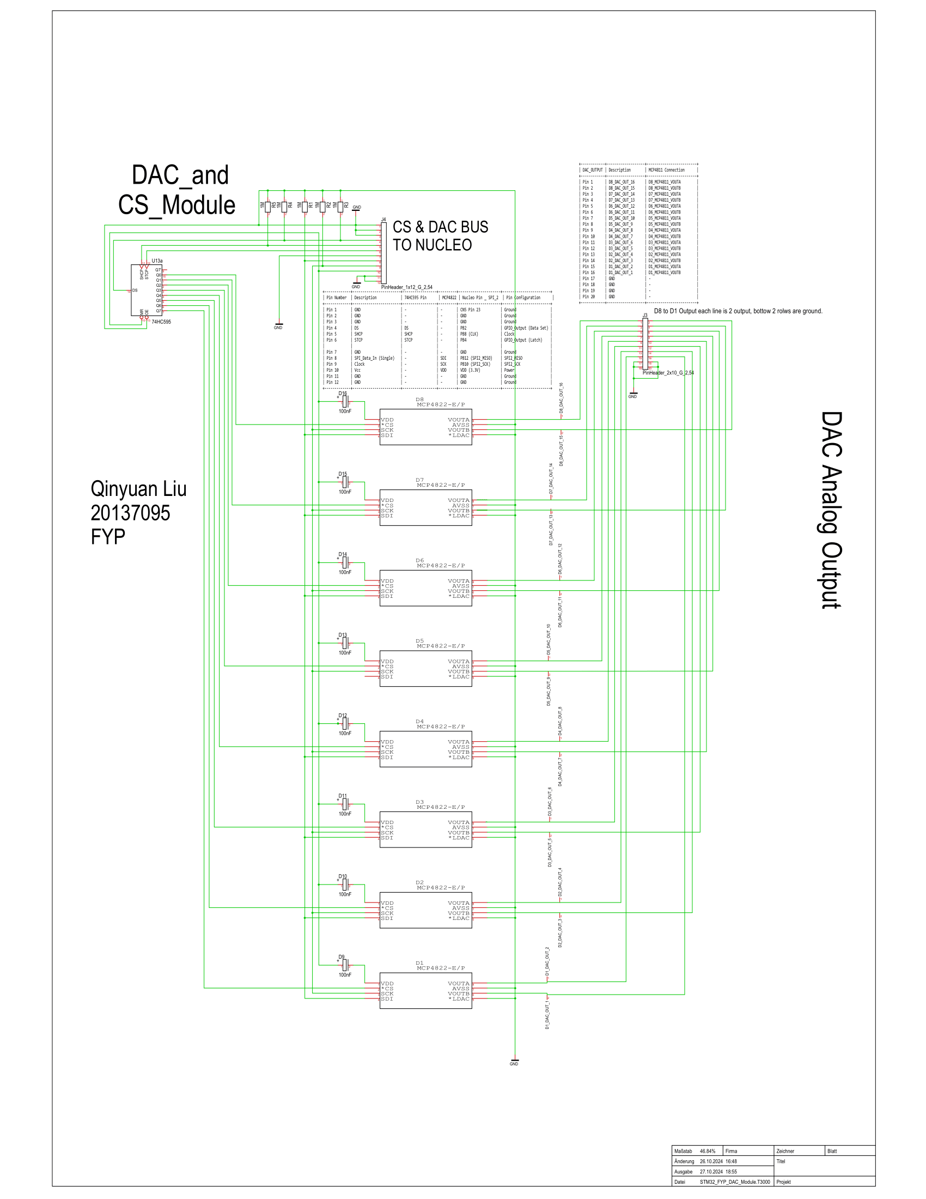
Printables/PNG/STM32_FYP_DAC_Module-1.png
