Qinyuan72/FYP/Printables/PNG/STM32_FYP_Digital_In_Module-1.png

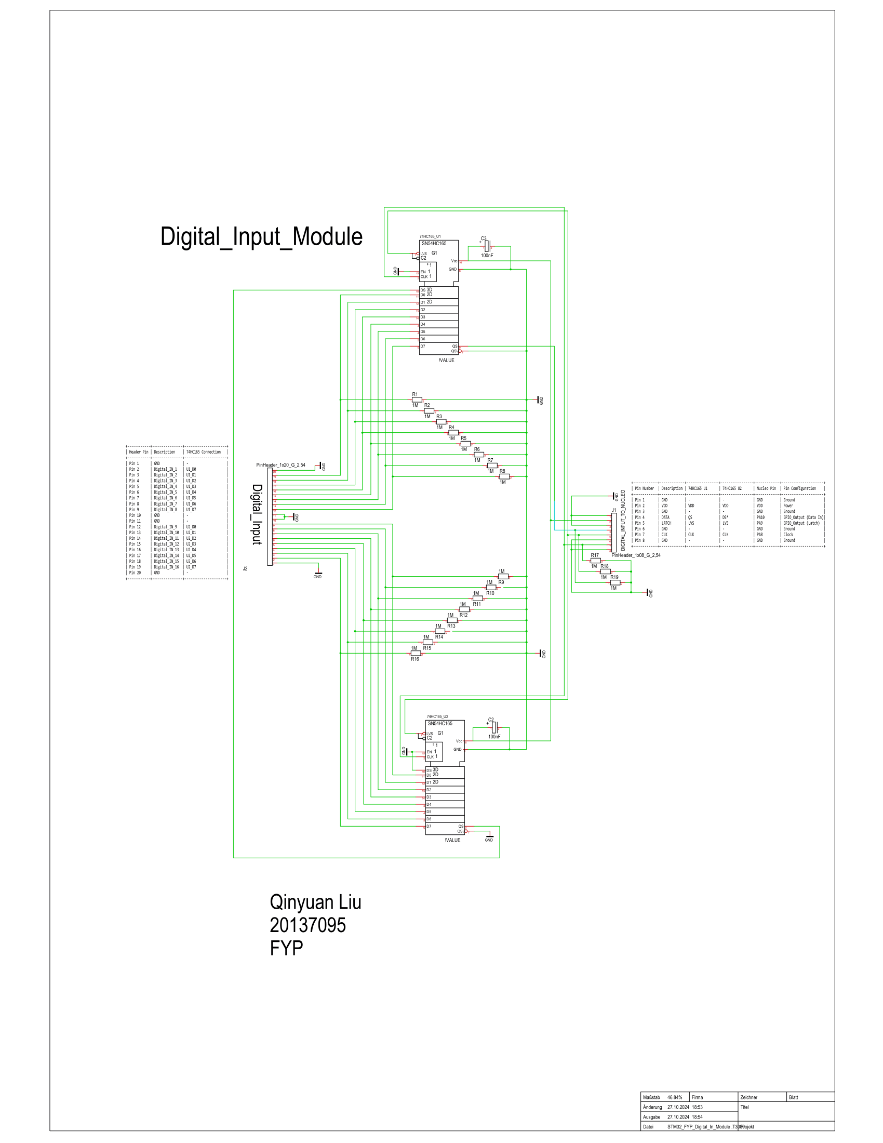
Printables/PNG/STM32_FYP_Digital_In_Module-1.png
