Qinyuan72/FYP/Printables/STM32_FYP_Digital_In_Module.pdf

# Digital_Input_Module

# 100nF C2 + GND GND GND GND


Ausgabe Änderung | Projekt Titel Firma Zeichner Blatt Datei Maßstab
