Qinyuan72/FYP/Printables/FYP_Block_DIagra_Print.pdf

NUCLAEO-L476RG NUCLAEO-L476RG
