Qinyuan72/FYP/Printables/STM32_FYP_DAC_Module.pdf

# CS_Module

# DAC_and


Ausgabe Änderung | Projekt Titel Firma Zeichner Blatt Datei Maßstab
