Qinyuan72/FYP/Printables/STM32_FYP_Digital_Out_Module.pdf

Änderung | Zeichner Projekt Titel Firma Blatt Datei Maßstab
