Qinyuan72/FYP/Drawings/AD PCB/STM32_FYP_ADC_Module/STM32_FYP_ADC_Module.pdf

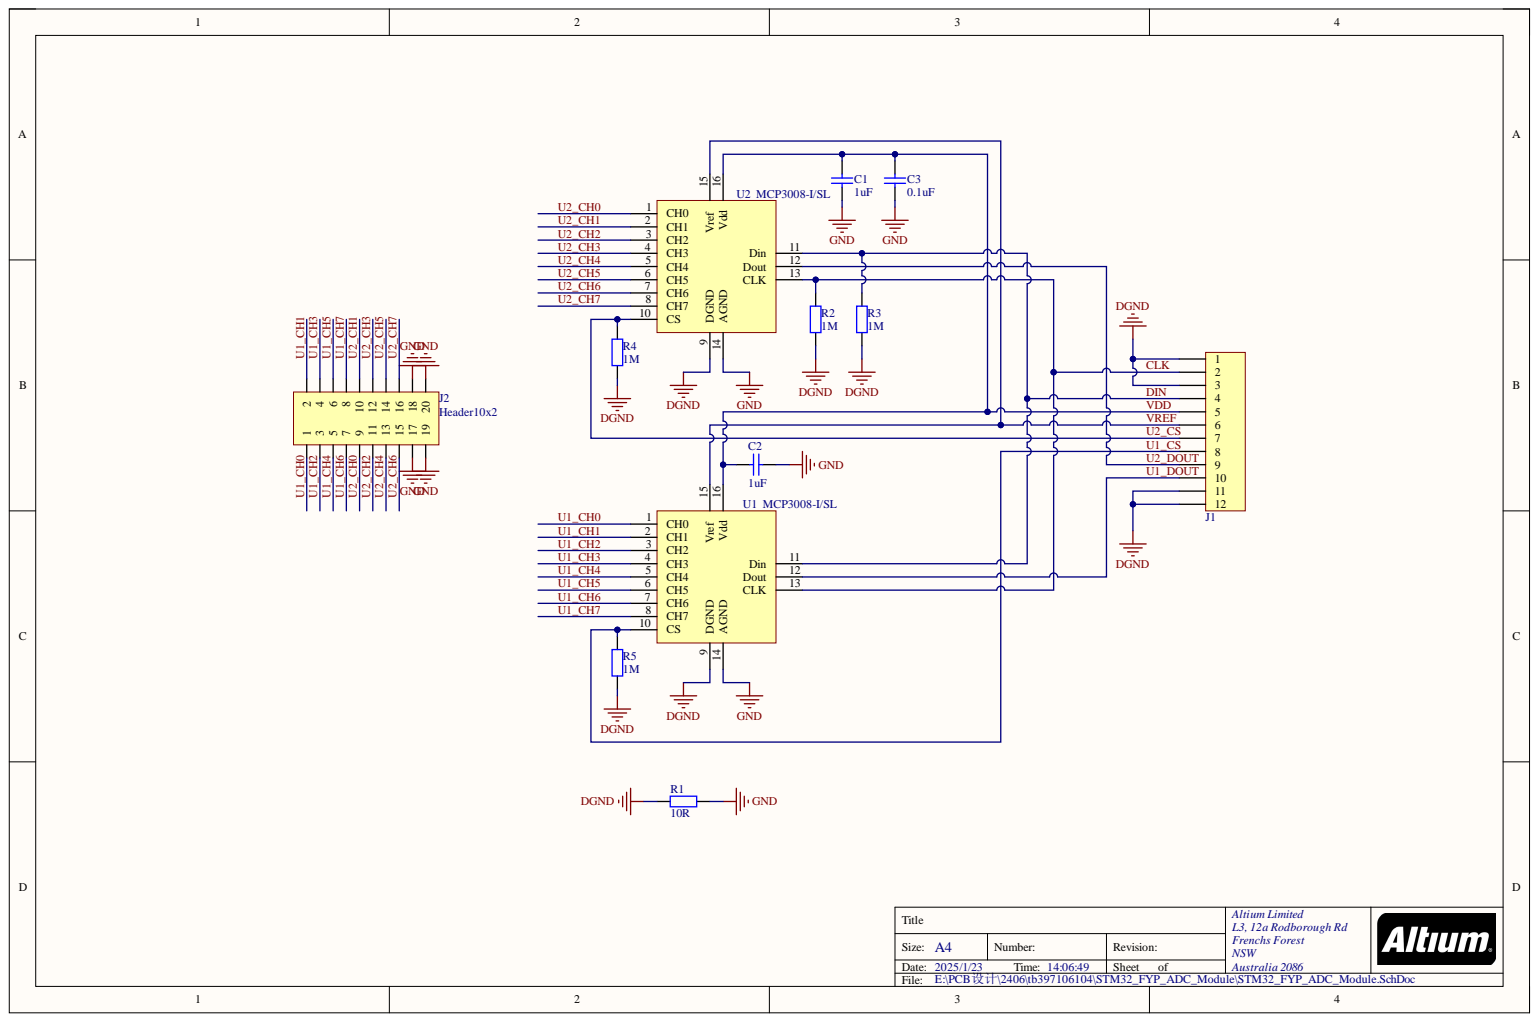
[picture p63: page 1]

V D D
VRE F
U 2 _CS
U 1 _CS
U 2 _ D | O U T

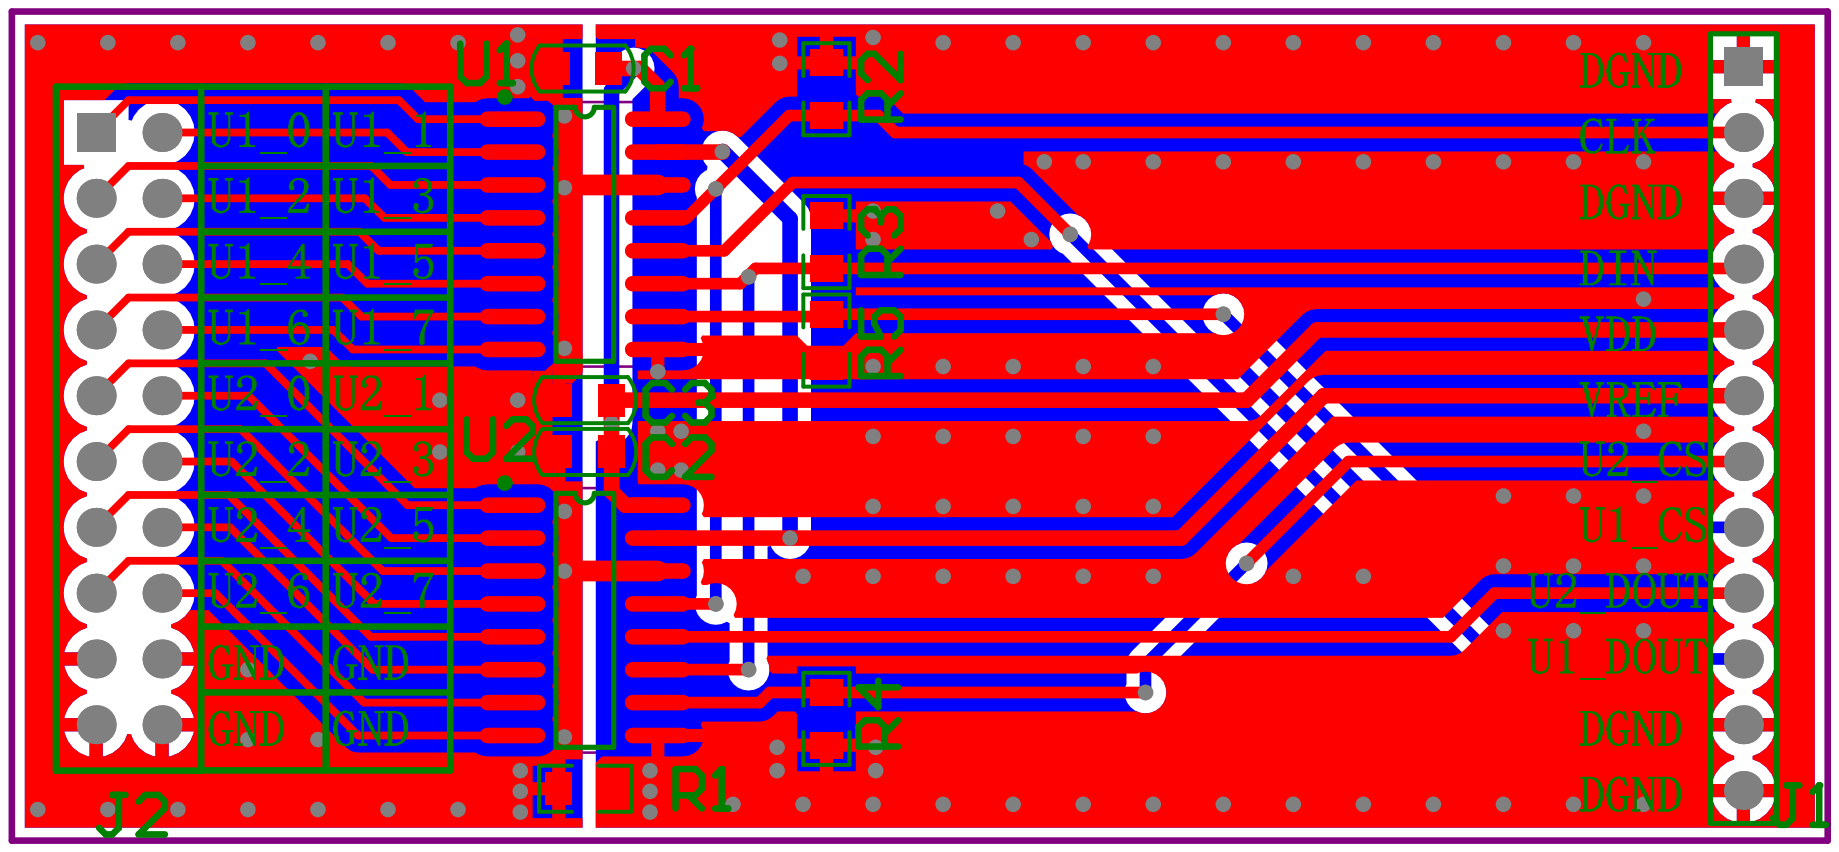
[picture p64: page 2]
