Qinyuan72/FYP/Drawings/AD PCB/STM32_FYP_DAC_Module/STM32_FYP_DAC_Module.pdf

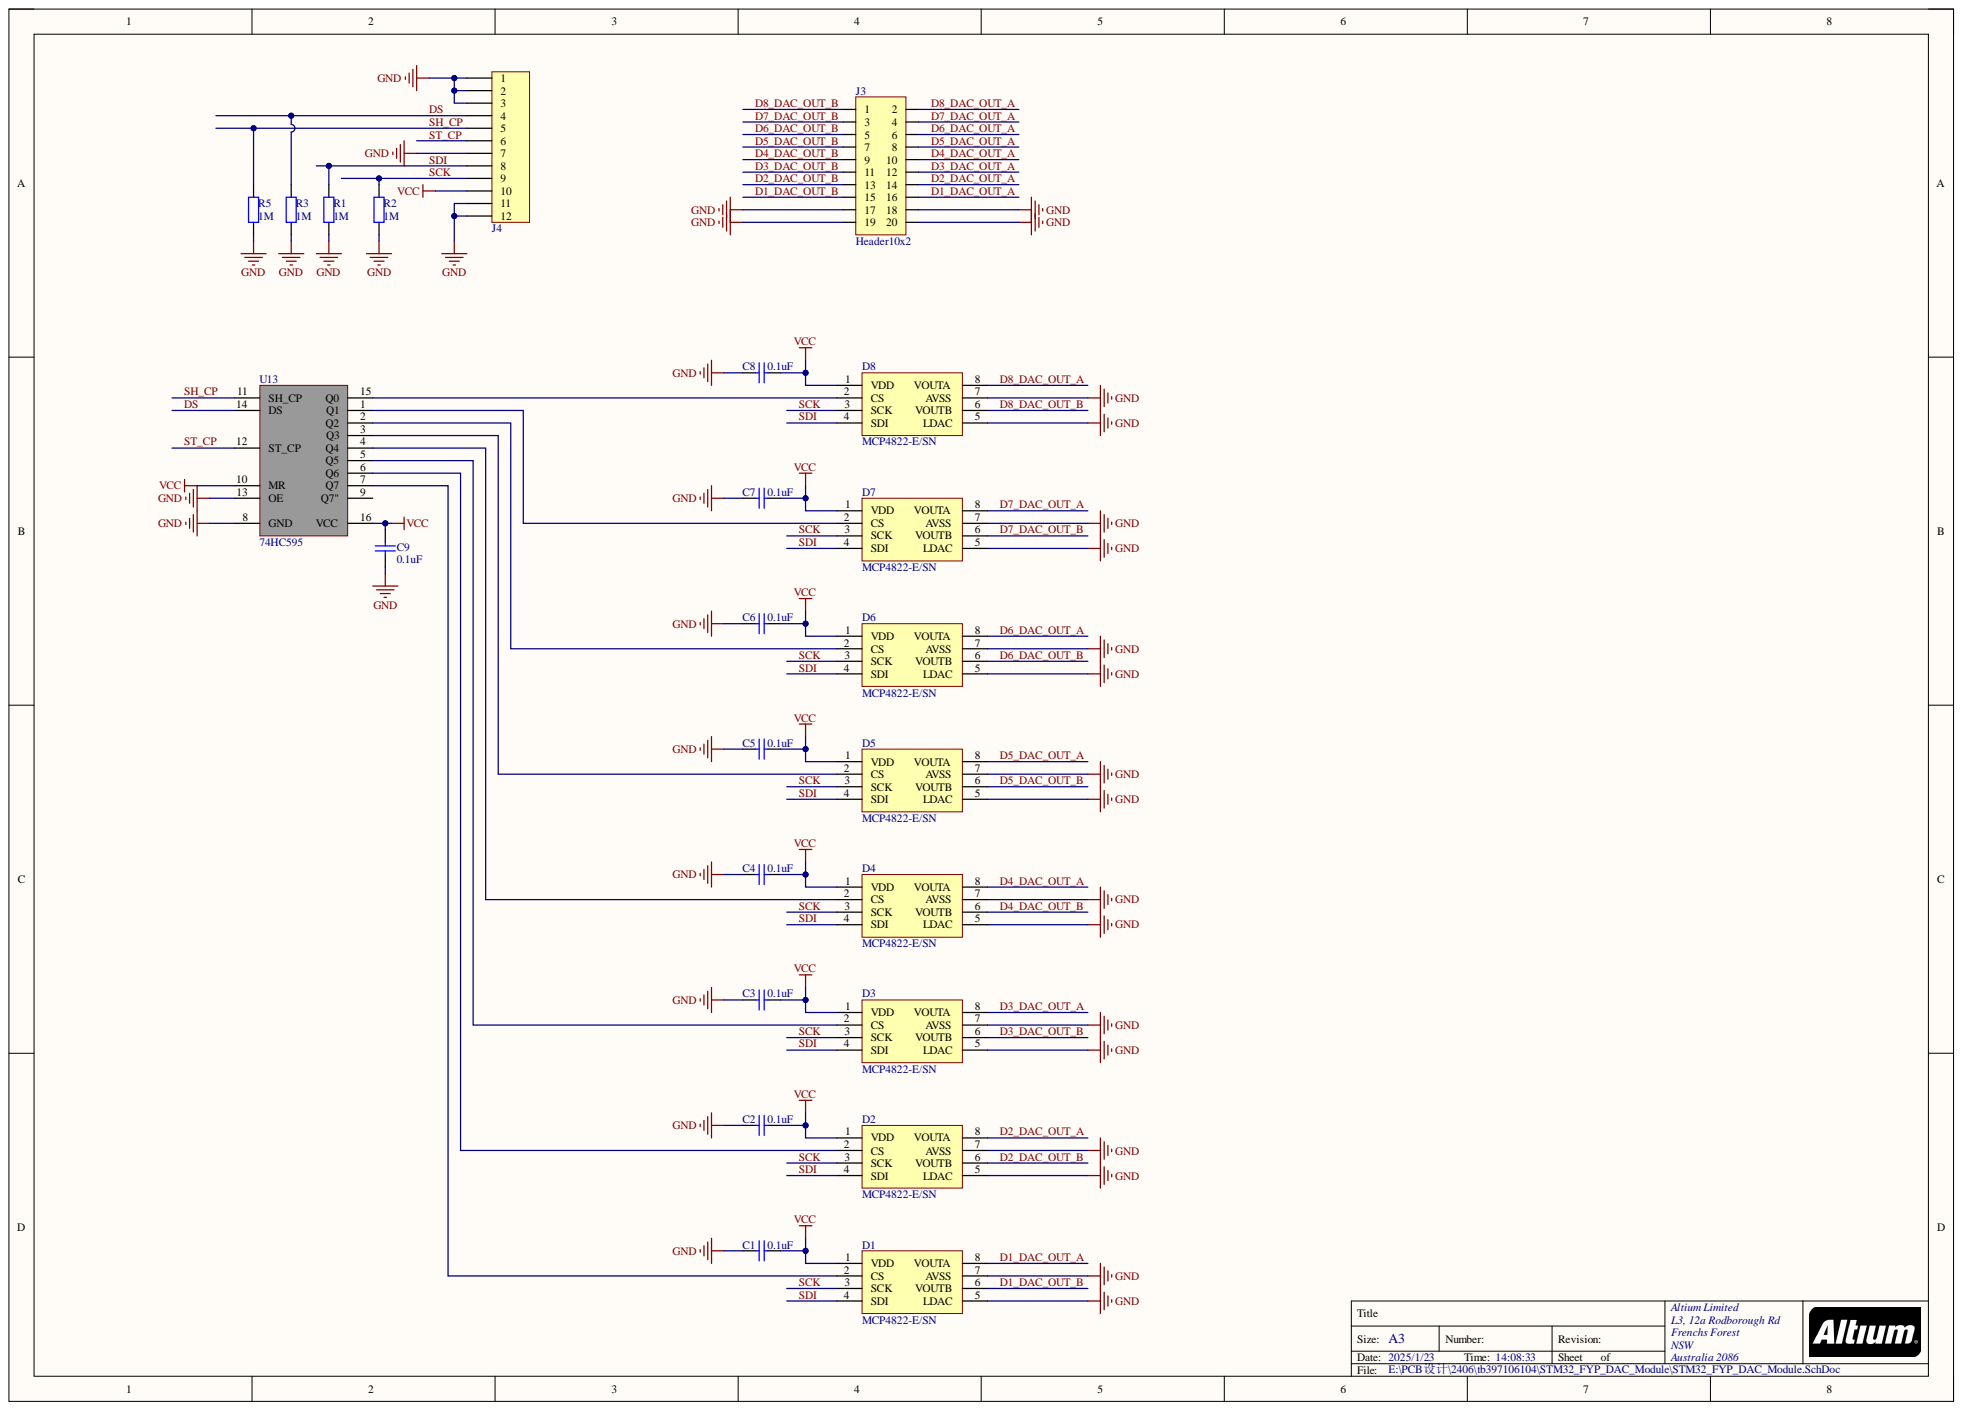
[picture p65: page 1]

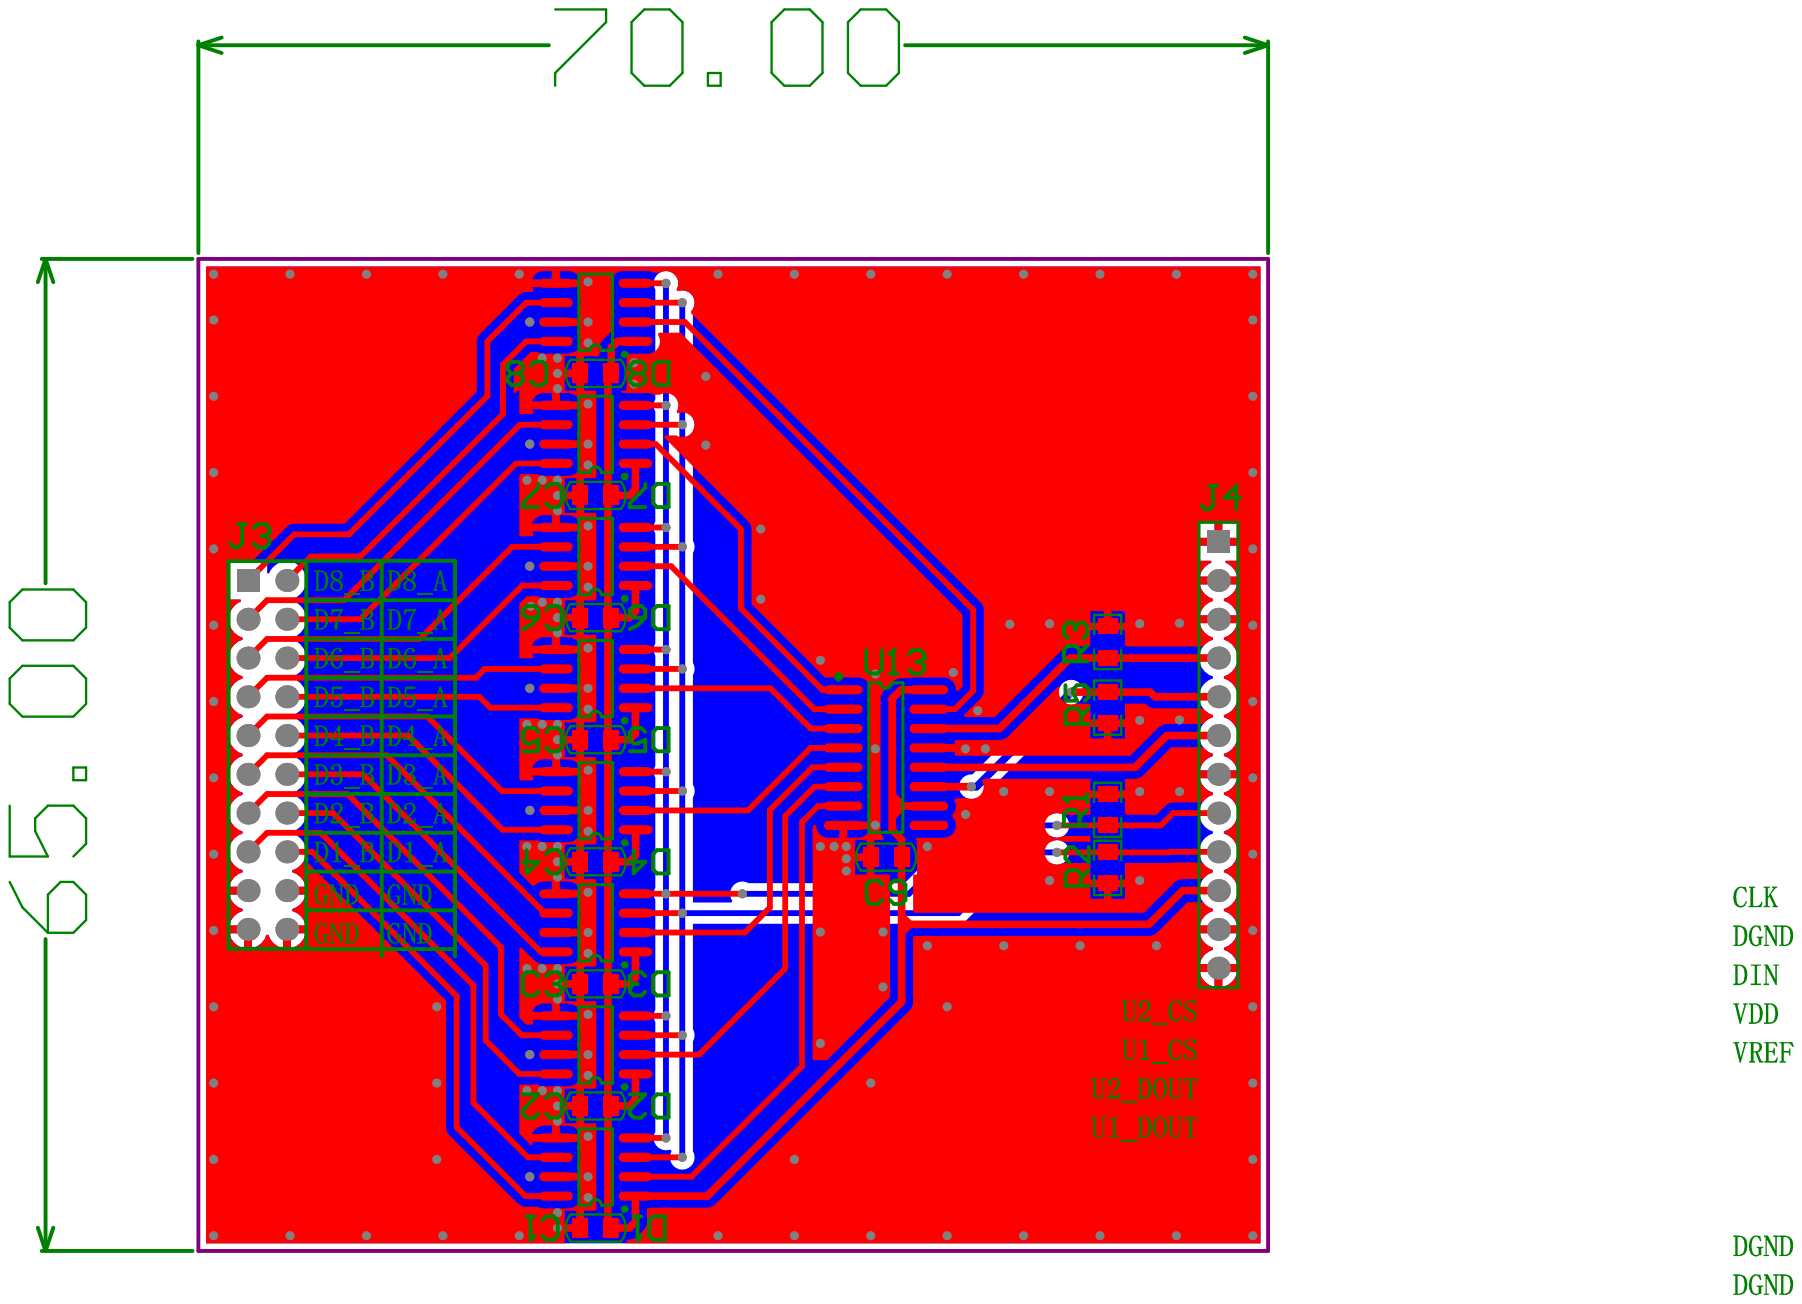
[picture p66: page 2]
