Qinyuan72/FYP/Drawings/AD PCB/STM32_FYP_Digital_In_Module/STM32_FYP_Digital_In_Module.pdf

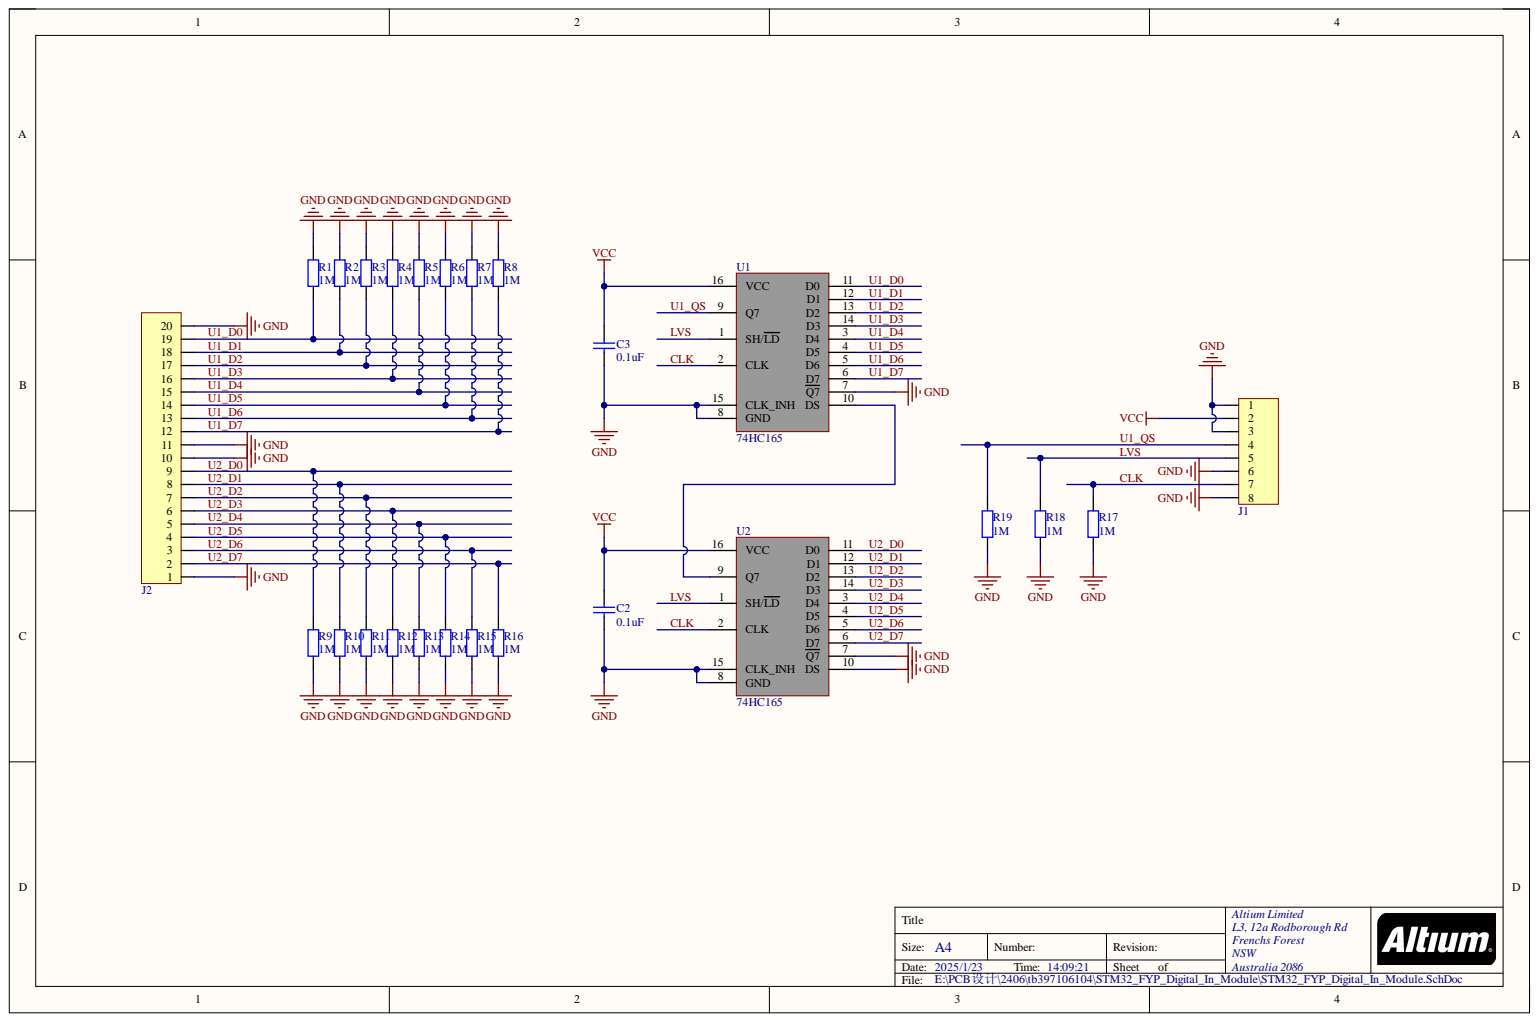
[picture p67: page 1]

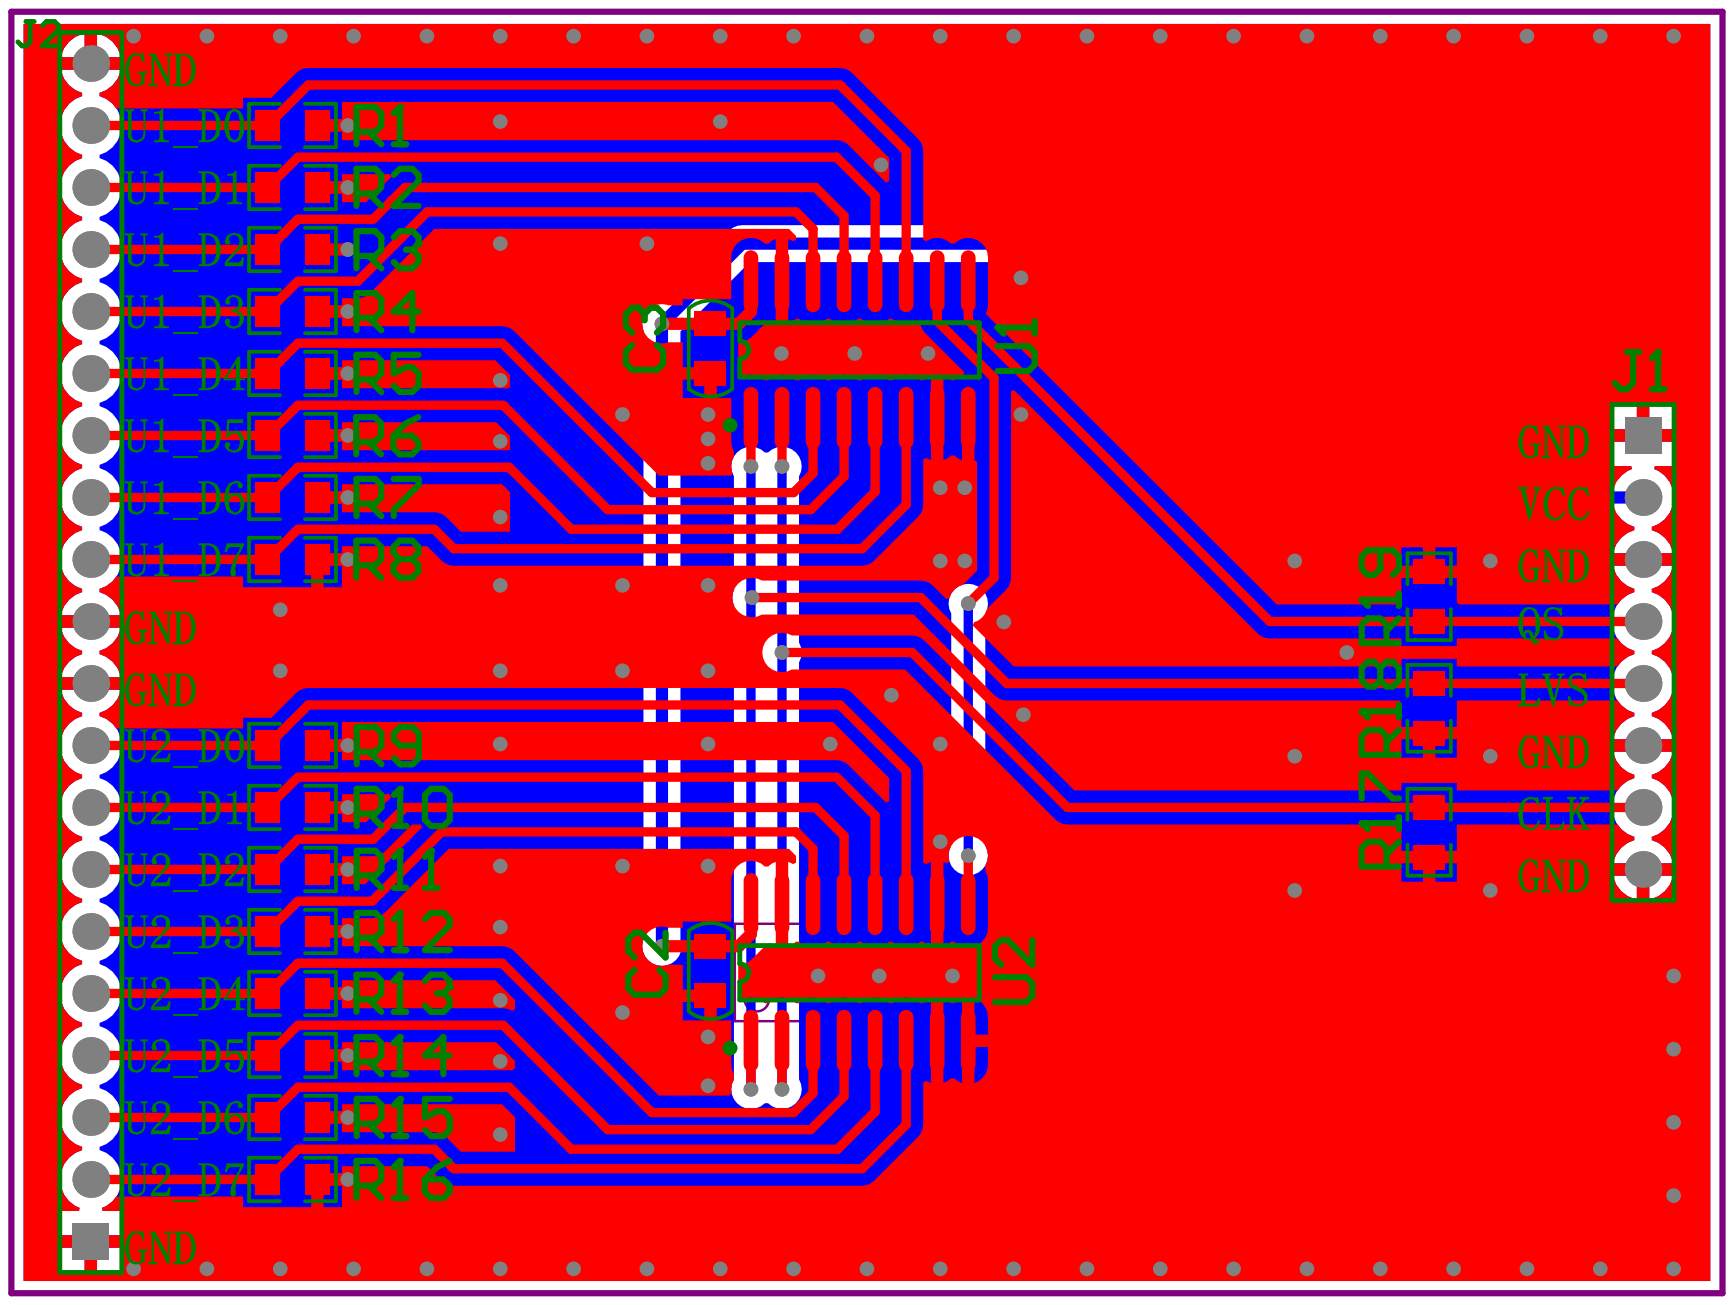
[picture p68: page 2]
