Qinyuan72/FYP/(list of files, drawings)

Other design files:
Drawings/AD PCB/STM32_FYP_ADC_Module/STM32_FYP_ADC_Module.PcbDoc
Drawings/AD PCB/STM32_FYP_ADC_Module/STM32_FYP_ADC_Module.PrjPcb
Drawings/AD PCB/STM32_FYP_ADC_Module/STM32_FYP_ADC_Module.SchDoc
Drawings/AD PCB/STM32_FYP_DAC_Module/STM32_FYP_DAC_Module.PcbDoc
Drawings/AD PCB/STM32_FYP_DAC_Module/STM32_FYP_DAC_Module.PrjPcb
Drawings/AD PCB/STM32_FYP_DAC_Module/STM32_FYP_DAC_Module.SchDoc
Drawings/AD PCB/STM32_FYP_Digital_In_Module/STM32_FYP_Digital_In_Module.PcbDoc
Drawings/AD PCB/STM32_FYP_Digital_In_Module/STM32_FYP_Digital_In_Module.PrjPcb
Drawings/AD PCB/STM32_FYP_Digital_In_Module/STM32_FYP_Digital_In_Module.SchDoc
Drawings/AD PCB/STM32_FYP_Digital_Out_Module/74HC595.PcbDoc
Drawings/AD PCB/STM32_FYP_Digital_Out_Module/74HC595.PrjPcb
Drawings/AD PCB/STM32_FYP_Digital_Out_Module/74HC595.SchDoc
