Qinyuan72/FYP/STM32CubeIDEworkspace_1.13.0/USART/Core/Src/main.c

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
/* Includes ------------------------------------------------------------------*/
#include "main.h"

UART_HandleTypeDef huart2;

/* USER CODE BEGIN PV */
uint8_t tx_buffer[27] = "Hello world!\n\r";
uint8_t rx_index;
uint8_t rx_data[32];
uint8_t rx_buffer[100];
uint8_t transfer_cplt;
/* USER CODE END PV */

void SystemClock_Config(void);
static void MX_GPIO_Init(void);
static void MX_USART2_UART_Init(void);
/**
  * @brief  The application entry point.
  * @retval int
  */
int main(void)
{
  /* MCU Configuration--------------------------------------------------------*/

  /* Reset of all peripherals, Initializes the Flash interface and the Systick. */
  HAL_Init();

  /* Configure the system clock */
  SystemClock_Config();

  /* Initialize all configured peripherals */
  MX_GPIO_Init();
  MX_USART2_UART_Init();
  /* USER CODE BEGIN 2 */
  HAL_UART_Receive_IT(&huart2, rx_data, 6);
  /* USER CODE END 2 */

  /* Infinite loop */
  /* USER CODE BEGIN WHILE */
  while (1)
  {
    /* USER CODE END WHILE */

    /* USER CODE BEGIN 3 */
//	  HAL_UART_Transmit(&huart2, tx_buffer, 27, 10);
//	  HAL_Delay(1000);
  }
  /* USER CODE END 3 */
}

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
/* USER CODE BEGIN 4 */


void HAL_UART_RxCpltCallback(UART_HandleTypeDef *huart)
{
  /* Prevent unused argument(s) compilation warning */
    if (huart->Instance == USART2) {
        // Transmit the received data back
        HAL_UART_Transmit(&huart2, rx_data, 1, HAL_MAX_DELAY);

        // Prepare for the next reception
        HAL_UART_Receive_IT(&huart2, rx_data, 1);
    }
}
/* USER CODE END 4 */
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
