Qinyuan72/FYP/(commit log)

2024-10-23 Need backup
    [FYP_Block_DIagram_Print.dwg, Header_Tables.xlsx]
2024-10-23 ADC Schematics Completed and folder Modifications
2024-10-24 Schmatics done
    [Header_Tables.xlsx]
2024-10-26 All Table and Drawing for the Report Done
    [Header_Tables.xlsx, RTOS task priority diagram.dwg]
2024-10-27 A lot of works
    [FYP_Block_DIagram_Print.dwg, FYP_Qinyuans_Project_implmentaion_Gantt_Chart.xlsx, RTOS task priority diagram.dwg]
2024-10-29 FYP Project_Interim_Report Submmssion
    [FYP_Block_DIagram_Print.dwg, FYP_Qinyuans_Project_implmentaion_Gantt_Chart.xlsx, Header_Tables.xlsx]
2024-12-07 License (授权协议)
2024-12-07 代码库同步
2025-03-26 Can't belive I am still well alive and able to code, nice
    [74HC595.PcbDoc, 74HC595.PrjPcb, 74HC595.SchDoc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]
